schult/midi_concertina/README.md

# MIDI Anglo Concertina

This is a 30-button Anglo Concertina MIDI controller. Click the image below to
watch a short demo:

Demo (https://www.youtube.com/watch?v=fJiAhQMkQ5o)

[Build Instructions](mechanical/README.md)
