schult/midi_concertina/mechanical/README.md

# MIDI Concertina - Mechanical

## Materials

| Quantity | Part |
| ---: | :--- |
| | [PETG Filament](https://shop.polymaker.com/products/polymaker-petg?variant=45079221108793) |
| | [TPU Filament](https://shop.polymaker.com/products/polyflex-tpu95?variant=39574341681209) |
| 34 | [Heat Set Insert M3 x 5.7](https://cnckitchenus.store/products/heat-set-insert-m3-x-5-7-100-pieces) |
| 3 | [M3 x 6mm Button Head Screw](https://boltdepot.com/Product-Details?product=7218) |
| 10 | [M3 x 10mm Button Head Screw](https://boltdepot.com/Product-Details?product=7220) |
| 1 | [M3 x 16mm Button Head Screw](https://boltdepot.com/Product-Details?product=7222) |
| 4 | [M3 x 20mm Button Head Screw](https://boltdepot.com/Product-Details?product=7223) |
| 12 | [M3 x 40mm Flat Head Screw](https://boltdepot.com/Product-Details?product=18839) |
| 2 | [M3 x 8mm Flat Head Screw](https://boltdepot.com/Product-Details?product=7213) |
| 2 | [#6 Finishing Washer](https://boltdepot.com/Product-Details?product=2937) |
| 3' | [16 Gauge Brass Wire](https://www.acehardware.com/departments/hardware/chain-and-rope/wire/52796) |
| 31 | [55g Keyboard Switch Spring](https://www.amazon.com/DUROCK-Mechanical-Keyboard-Compatible-Switches/dp/B09TD7CF3H) |
| 30 | [3mm x 1mm Neodymium Magnet](https://www.amazon.com/MEALOS-Magnets-3mmx1mm-Miniatures-Storage/dp/B08NZSL2V6) |
| 18" | [12 Gauge Steel Hanging Wire](https://www.lowes.com/pd/RELIABILT-1200-in-Hanger-Wire/1002920292) |
|  12" x 3" | [4 oz Black Leather](https://leatherboxusa.com/products/tuscany-collection-soft-vegetable-tanned-vachetta-leather-3-5-4-0) |
| 1 | [Bivar GLP1-188-F-54 Light Pipe](https://www.digikey.com/en/products/detail/bivar-inc/GLP1-188-F-54/26730936) |
| 4 | [Würth Elektronik 6-Pin WR-WST REDFIT IDC](https://www.digikey.com/en/products/detail/w%C3%BCrth-elektronik/490107670612/7917217) |
| 3' | [6 Conductor Ribbon Cable](https://www.digikey.com/en/products/detail/3m/3365-06-300/2766998) |
| 1" | [2mm ID Silicone Tubing](https://www.dubro.com/products/super-blue-slicone-tubing?variant=39705737920596) |
| 24" x 20" | [Tyvek 1073D](https://www.etsy.com/listing/1759067642/75-grams-025mm-thickness-kraft-paper) |
| 16" x 20" | [2-Ply Museum Board](https://www.dickblick.com/items/rising-museum-board-32-x-40-x-2-ply-natural-sheet/) |
| | [PVA Glue](https://www.dickblick.com/products/gorilla-wood-glue/) |
| | [CA Glue](https://www.dickblick.com/products/gorilla-super-glue/) |
| | [1.5mm Elastic Cord](https://www.beadtin.com/products/black-1-5mm-round-elastic-cord-22m) |
| 1 | Controller PCBA |
| 1 | Left Keyboard PCBA |
| 1 | Right Keyboard PCBA |
| 1 | Bellows Sensor PCBA |

## Tools

This is not an exhaustive list. Basic measuring, marking, and cutting tools are
assumed.

### Required

#### FDM 3D Printer

Any modern printer that can print PETG and TPU with a 0.4mm nozzle and a build
volume of at least 180mm x 180mm x 30mm should be up to the task.

#### Soldering Iron and [M3 Heat Set Installation Tip](https://cnckitchenus.store/collections/installation-tips-and-sets-1)

If you don't already have a soldering iron, CNCKitchen
[sells one in a set](https://cnckitchenus.store/products/soldering-iron-t90b?variant=48105538814052)
with the required installation tip included.

There are less expensive tools/methods for installing heat set inserts, but I
can't vouch for the quality of their results.

### IDC Crimping Tool

I use a [3D printed tool](https://www.printables.com/model/1472991-we-wst-connector-6p-manual-press-tool)
in a bench vise.

### Optional

#### Laser Cutter

A laser cutter does a nice job of cutting out hand straps and bellows cards.
A 10W diode laser with air assist is sufficient. Use it if you have it.

#### [Wire Straightener](https://www.amazon.com/dp/B09C5RWY1S)

This should be able to handle both 12 gauge steel wire and 16 gauge brass wire.

This is faster and easier than straightening wires by hand, and it produces
superior results. That said, it's a specialized tool that's not super cheap, so
it's probably not worth the cost if you're only building one instrument.

## 3D Printing Parts

### Part Index

| Quantity | Part |
| ---: | :--- |
| 1 | ActionBoard\_Left |
| 1 | ActionBoard\_Right |
| 2 | BellowsFrame |
| 31 | ButtonBushing |
| 31 | ButtonCap |
| 1 | ButtonFlange\_Air |
| 30 | ButtonFlange\_Note |
| 1 | ControllerPanel |
| 1 | ControllerPanelButton |
| 1 | ControllerPanelRetainer |
| 1 | Faceplate\_Left |
| 1 | Faceplate\_Right |
| 2 | Handrest |
| 31 | MagnetPost |
| 1 | PcbStandoff1\_Left |
| 1 | PcbStandoff1\_Right |
| 2 | PcbStandoff2 |
| 2 | Trim |
| 1 | ValveBlock\_Left |
| 1 | ValveBlock\_Right |

### Parameters

Many key dimensions are stored in spreadsheets in Parameters.FCStd to be
referenced by the other FreeCAD files. A few of these may need to be adjusted to
accomodate your 3d printing setup:

- `CommonParams.clearance_tight` sets the clearance between press-fit 3d-printed
  parts. Test with ControllerPanel and ControllerPanelRetainer, since these
  are smaller parts.
- `HardwareParams.m3_insert_hole_diameter` and
  `HardwareParams.m3_insert_horizontal_hole_diameter` adjust the hole sizes
  for the threaded inserts.
- `ButtonParams.wire_press_fit_diameter` sets the inner diameter for button
  wires to press-fit into. Wires should punch through these layers without
  excessive effort and remain firmly in place once fully seated.
- `ButtonParams.wire_clearance_diameter` sets the size of the ActionBoard holes
  that the wires pass through. These should be as closely fitted as possible
  while still allowing the wires to slide freely.
- `ButtonParams.magnet_diameter` should be adjusted so that the magnets are easy
  to insert into MagnetPost mid-print but don't jump out as the nozzle passes
  over them.
- TODO: Handrest buckle prong hole diameter?
- TODO: Button jig cutter allowance?
- TODO: ControllerPanel light pipe press-fit

When changing these or other spreadsheet values, it is recommended to open
Parameters.FSCStd first, then open all other FreeCAD files, edit the parameters,
and finally recompute the Body in each file before saving it. This ensures that
all dependent parts are correctly updated.

### STL Export

Run `freecadcmd export_all.py` in this directory. The generated STL files will
be placed in the `exports` subdirectory.

### Slicer Settings

#### Base

- PETG
- 0.4 mm nozzle
- 0.2 mm layer height
- 15% Gyroid infill
- 2 wall loops

#### Deviations

The cable guide should be printed with TPU. I also recommend setting the top and
bottom surface patterns to "Concentric".

Bellows gaskets and button flanges should be printed with TPU.

Button caps should be printed with the smallest layer height possible. 0.08 mm
is good. This helps to reduce noise when pressing buttons and produces a
smoother top. It is recommended to use an outer brim when printing this part.

The magnet posts require a pause mid-print in order to insert the magnets.  They
should also be printed with the same layer height as the button caps to ensure
the wire press-fits the same way in both parts.

Handrests have a curved top that benefits from a reduced layer height of 0.12 mm
or less.

Faceplates and the controller panel should be printed with "Only one wall on
first layer" enabled.

I prefer the way the controller panel button looks with the top surface pattern
set to "Concentric".

Parts that incorporate threaded inserts should use 4 wall loops:

- ActionBoard\_Left
- ActionBoard\_Right
- BellowsFrame
- ControllerPanel
- Handrest
- PcbStandoff2
- ValveBlock\_Left
- ValveBlock\_Right

## Assembly Instructions

### Heat Set Inserts

Install heat set inserts in all parts that require them.

#### Left Action Board
Install 2 inserts in the left action board.

The holes for the inserts go all the way through, so check that you are
installing them from the side _without_ the spring pockets. While not strictly
necessary, this helps prevent melted plastic from obstructing the threads.

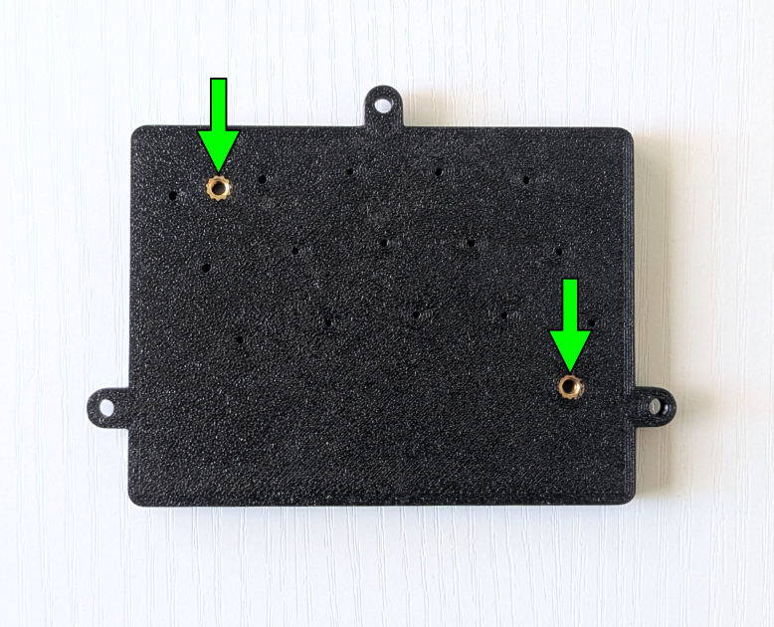
[picture p1: mechanical/docs/images/heat-set-inserts-left-action-board.jpg]
Left Action Board


#### Right Action Board
Install 2 inserts in the right action board.

The holes for the inserts go all the way through, so check that you are
installing them from the side _without_ the spring pockets. While not strictly
necessary, this helps prevent melted plastic from obstructing the threads.

Right Action Board

#### Bellows Frames (2x)
Install 6 inserts in each of the two bellows frames.

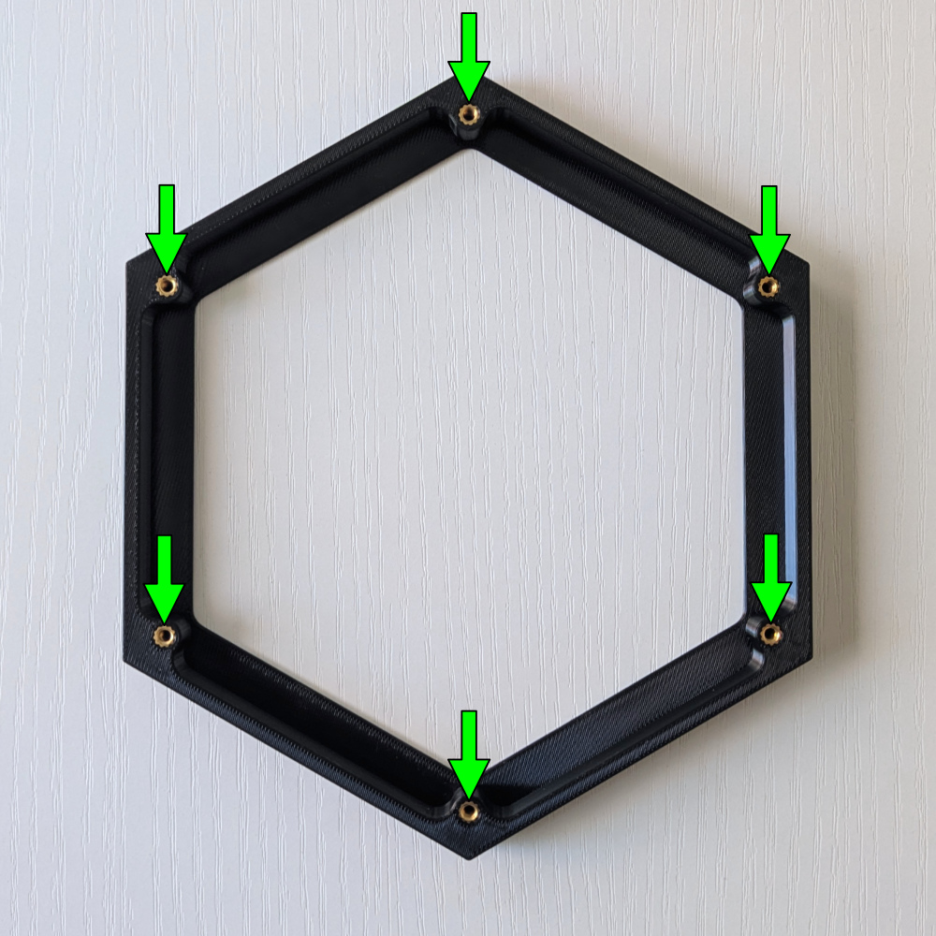
[picture p2: mechanical/docs/images/heat-set-inserts-bellows-frames.jpg]
Bellows Frames


#### Controller Panel
Install 2 inserts in the controller panel.

Controller Panel

#### Handrests (2x)
Install 3 inserts in each of the two handrests.

Handrests

#### PCB Standoffs (2x)
Install 1 insert in each of the two larger PCB standoffs.

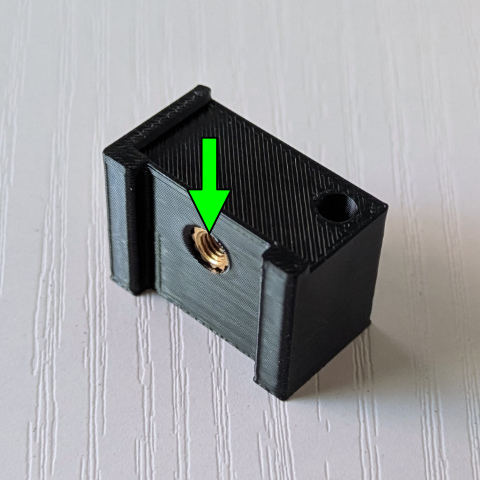
[picture p3: mechanical/docs/images/heat-set-inserts-pcb-standoffs.jpg]
PCB Standoffs


#### Left Valve Block
Install 4 inserts in the left valve block.

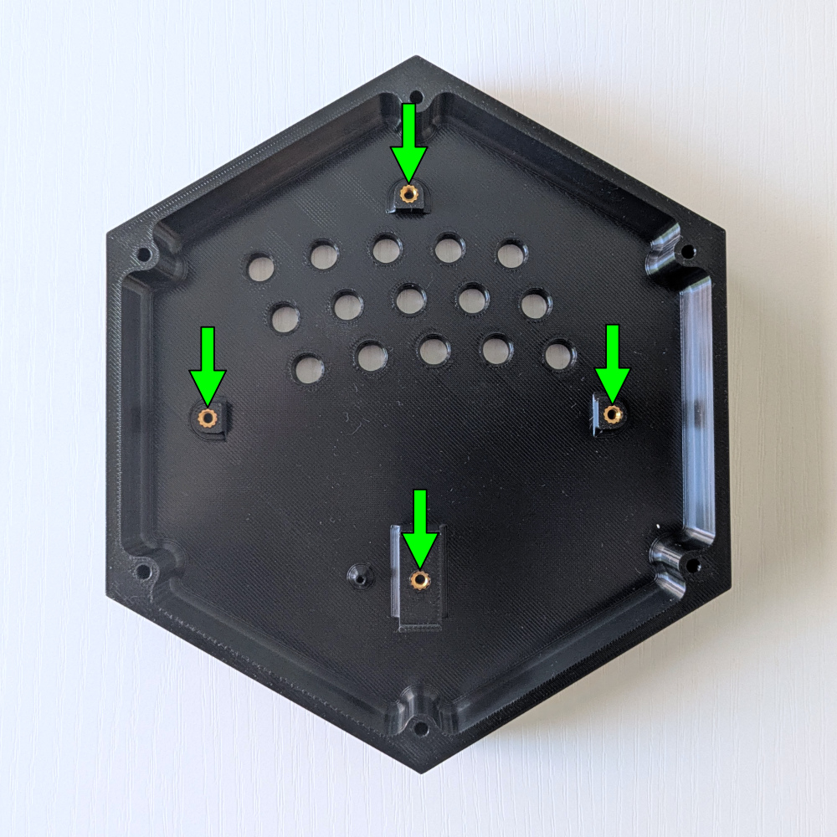
[picture p4: mechanical/docs/images/heat-set-inserts-left-valve-block.jpg]
Left Valve Block


#### Right Valve Block
Install 4 inserts in the right valve block.

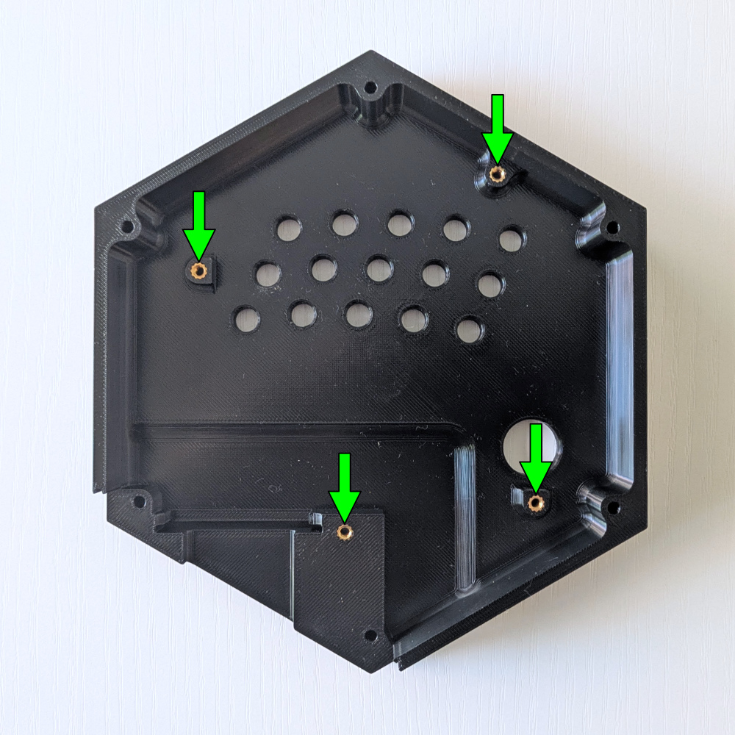
[picture p5: mechanical/docs/images/heat-set-inserts-right-valve-block.jpg]
Right Valve Block


### Handrest Buckles (2x)

Each handrest buckle is constructed from two lengths of straightened 12 gauge
steel hanging wire.

#### Frame

Make marks 12mm, 63mm, 80mm, 121mm, and 136mm from the end of the wire.

Buckle Frame Measurements

At the first mark, hold the wire firmly with pliers on the side closest to the
end, and make a 90-degree bend. Repeat this for each of the following three
marks, making all bends in the same direction.

Buckle Frame Bend 1
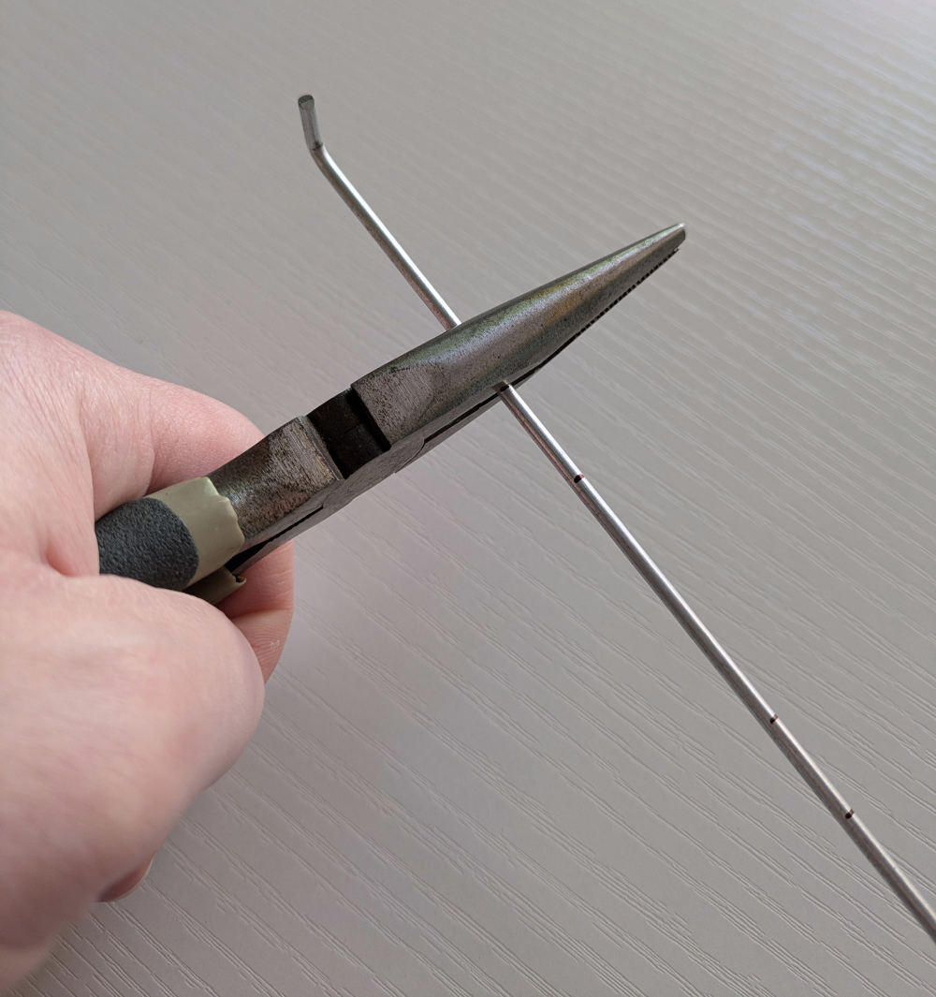
[picture p6: mechanical/docs/images/handrest-buckle-frame-2.jpg]
Buckle Frame Bend 2

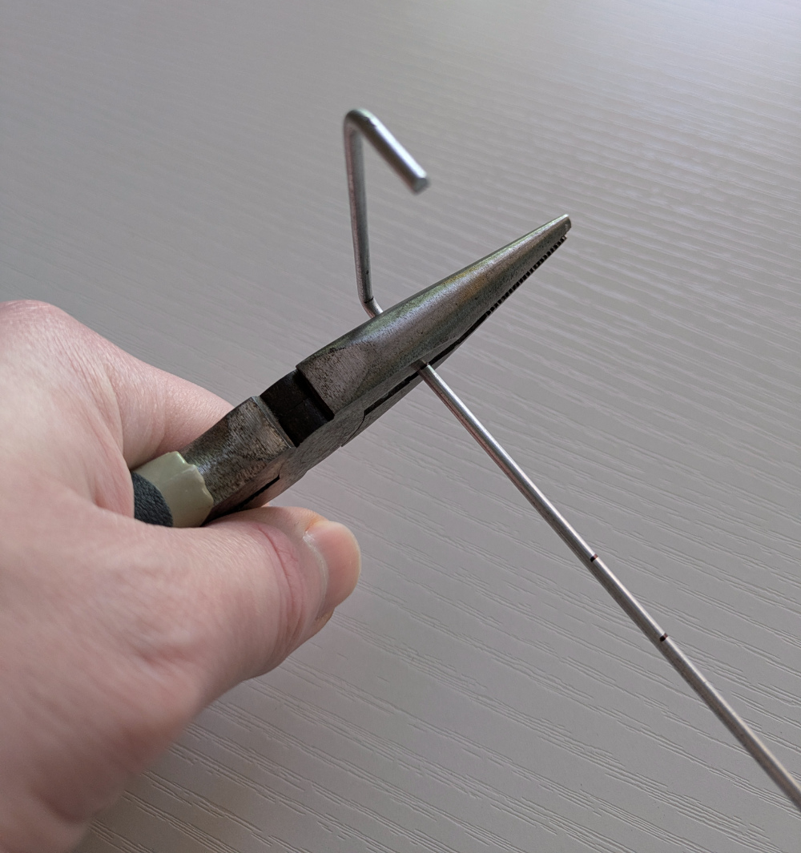
[picture p7: mechanical/docs/images/handrest-buckle-frame-3.jpg]
Buckle Frame Bend 3

Buckle Frame Bend 4

 Cut the wire at the final mark.

Buckle Frame Cut
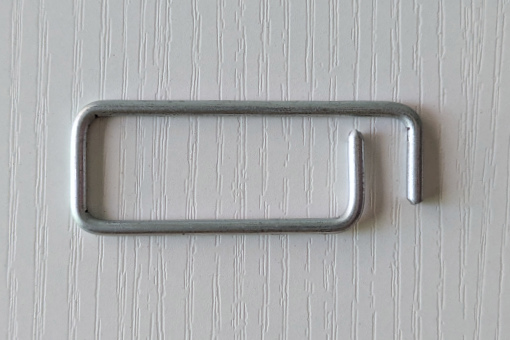
[picture p8: mechanical/docs/images/handrest-buckle-frame-finished.jpg]
Finished Buckle Frame


#### Prong

Round the end of the wire, then cut it to 16 mm long.

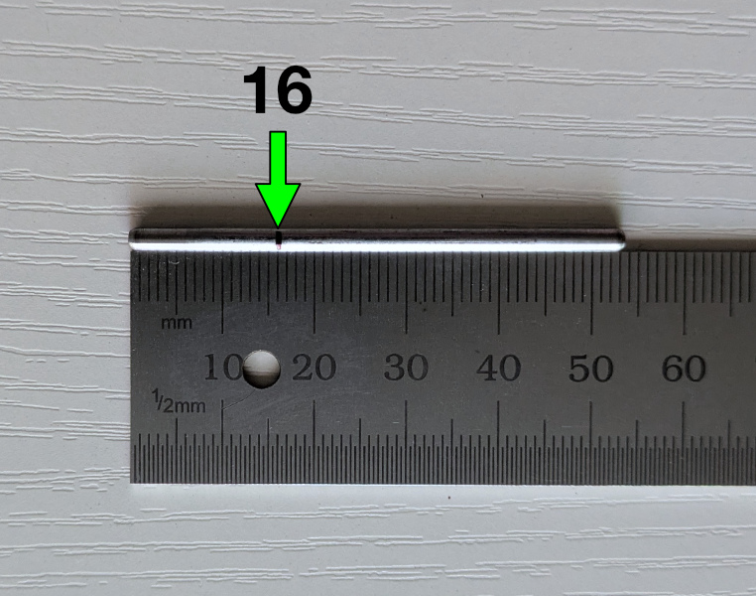
[picture p9: mechanical/docs/images/handrest-buckle-prong-measurements.jpg]
Buckle Prong Measurements

Finished Buckle Prong

#### Installation

With the short leg of the frame below the handrest, fit the longer leg of the
frame into the hole in the middle of the handrest. Pay attention to which side
of the handrest the leg is on (you want the right and left hands to match).

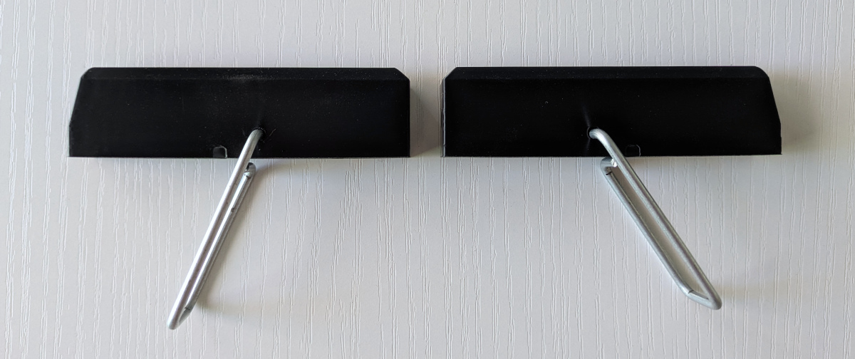
[picture p10: mechanical/docs/images/handrest-buckle-install-1.jpg]
Buckle Installation Step 1


Rotate the frame until the short leg snaps into the notch in the bottom of the
handrest.

Buckle Installation Step 2

Hold the frame past the prong hole while pressing the unfinished end of the
prong into the hole.

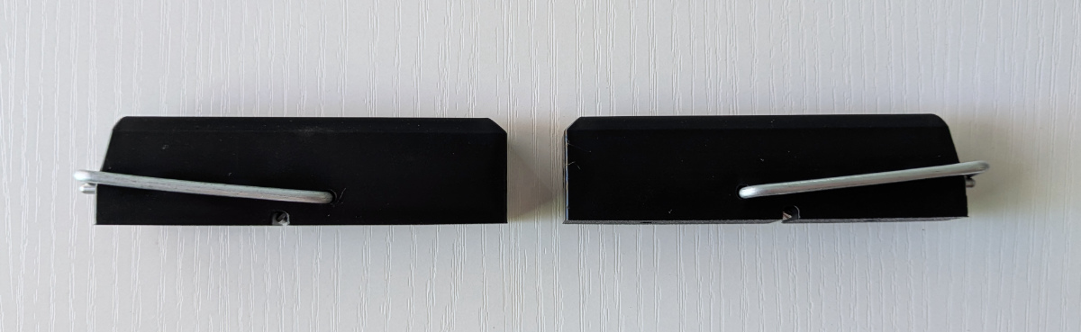
[picture p11: mechanical/docs/images/handrest-buckle-install-3.jpg]
Buckle Installation Step 3


### Faceplates

Press button bushings into all of the faceplate sockets.

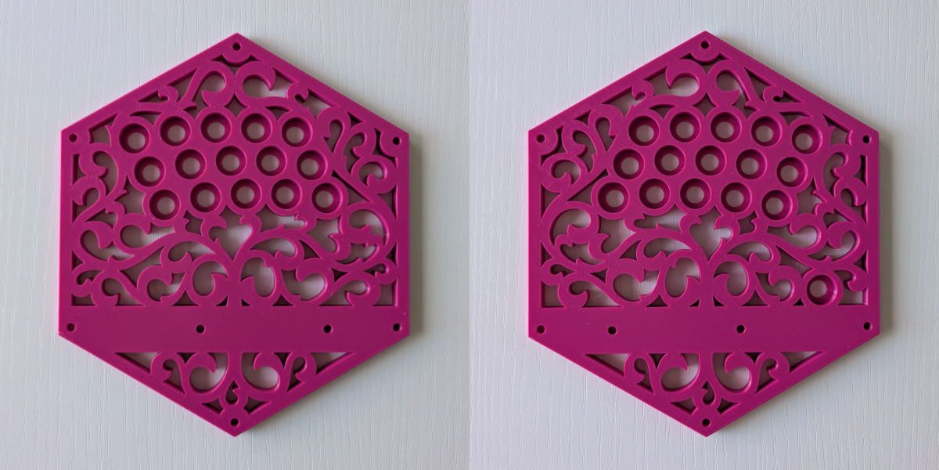
[picture p12: mechanical/docs/images/faceplate-initial.jpg]
Faceplates Without Button Bushings

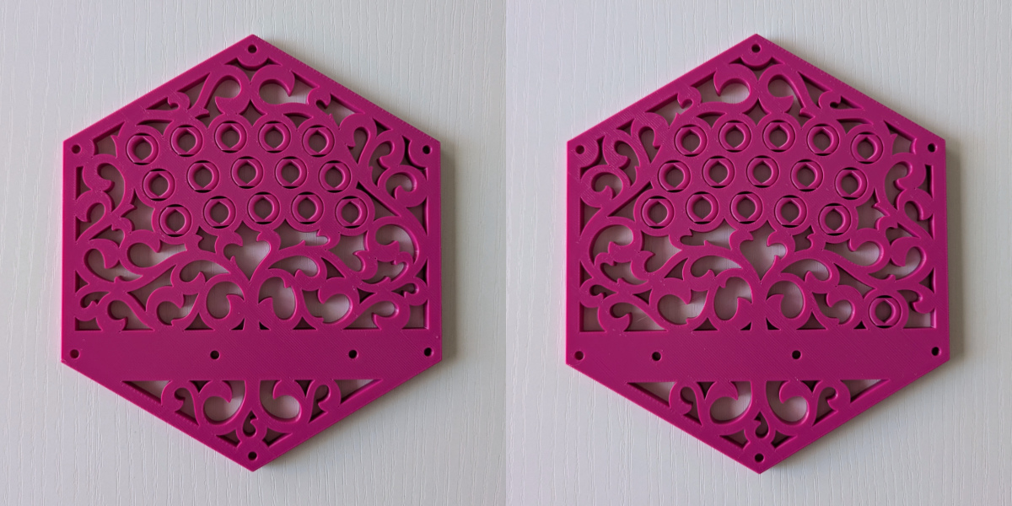
[picture p13: mechanical/docs/images/faceplate-button-bushings.jpg]
Faceplates With Button Bushings


Use two M3 x 10mm screws to bolt a handrest assembly to each faceplate. The
buckle prong should face the closer edge of the faceplate.

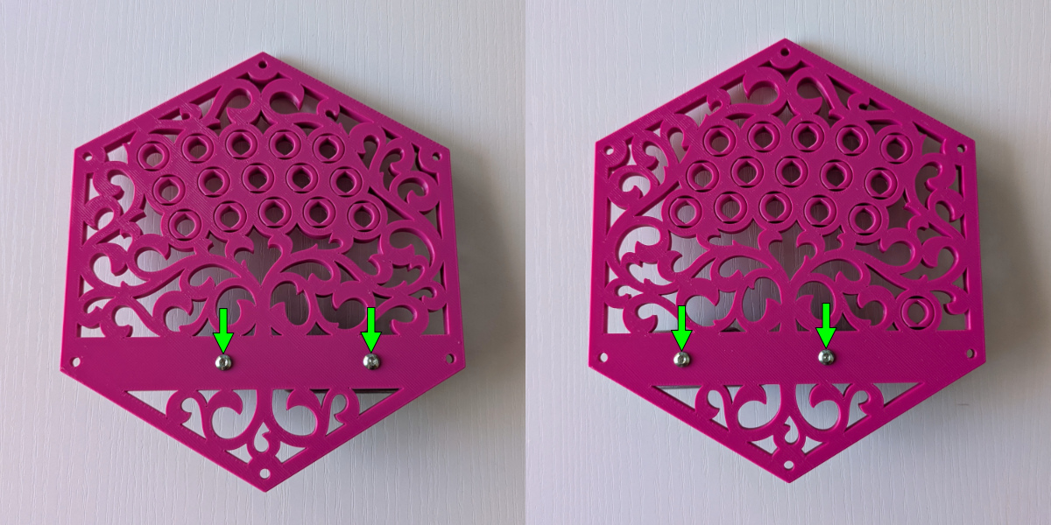
[picture p14: mechanical/docs/images/faceplate-handrest-screws.jpg]
Faceplate Handrest Screws

Faceplate Handrest Orientation

### Buttons

[tools/ButtonWireJig.FCStd](tools/ButtonWireJig.FCStd) is a tool to help with
measuring the button wires and seating them in button caps.

Insert 16 gauge brass wire in the hole in the short edge of the jig until it
stops. Place side cutters flush with the face of the jig and cut the wire. This
should produce a ??mm (TODO) long section of wire. Repeat this for each button.

For each button, insert a wire section in the hole in the long side of the jig.
Press a button cap onto the exposed end of the wire until it is fully seated. To
check that the wire is fully seated, place the wire in the exposed slot in the
jig, with the button cap flush against the side of the jig. The end of the wire
should come to the edge of the jig.

Push a button flange onto each of the wires, with the concave side facing
the button cap. Press it flush with the button cap.

### Action Boards

For each button, place a spring on its wire. Insert the wire through the
counterbored side of one of the holes in the action board. Press a magnet post
onto the end of the wire protruding from the opposite side of the action board.

Attach the action boards to their matching valve blocks with three M3 x ??mm
(TODO) screws each.

### Controller Panel

TODO

### Bellows

Cut a 516mm x 488mm piece of Tyvek. Also cut 42 25mm Tyvek squares.

Mark the card locations on the back side of the Tyvek. Cards should be on a 84mm
x 32mm grid. The first set of cards should hang about halfway off the edge of
the Tyvek, so that when the Tyvek is glued into a tube, the seam falls in the
middle of the cards instead of on the corners. A template to help quickly mark
card locations is included as a layer in [BellowsCards.dxf](BellowsCards.dxf).

Cut 84 cards in the shape found in layer `0` of
[BellowsCards.dxf](BellowsCards.dxf).

Glue the cards down to the Tyvek using PVA glue. Use enough glue that you see a
little squeeze-out when you press each card down. Allow the glue to dry before
continuing.

Fold the Tyvek along the bellows peaks and valleys. Glue 25mm Tyvek squares
across the cards that meet at the bellows valleys to act as a hinge. Allow the
glue to dry before continuing.

Flatten the Tyvek back out, then fold along two sets of corners so that the seam
lines up. Check that the card corners line up. Place a piece of waxed paper
inside the bellows under the seam to prevent gluing it to the opposite side.
Apply glue to the exposed cards and glue the entire seam closed. Allow the glue
to dry before continuing.

Open the bellows into a hexagonal tube, but do not fold the peaks and valleys
yet. Press the bellows frames into each end, pushing them past their final
position. Apply CA glue to the Tyvek where the frames will go. Pull the frames
out to their final position, and fold the Tyvek around them, being careful not
to block or clog the screw inserts. Allow the glue to dry before continuing.

Fold the valleys in and the peaks out. Adjust the gussets so they fold
symmetrically.

Tie seven loops of elastic cord about 270mm in circumference, and place one
around each bellows valley. Align the knots with the seam in the Tyvek.

### Electronics

TODO: Move these paragraphs to other sections?

For all PCBAs, the side with components is the front, and the opposite side is
the back. When viewing the back of a PCBA, its top and bottom edge can be found
by orienting it so that its name and revision are right-side up.

For each keyboard PCBA, insert two M3 x ??mm (TODO) screw through the holes in
its back. Place the PCB standoffs on the screws. Standoff 1 is for the top
corner and standoff 2 is for the bottom corner. Screw the PCBA to its matching
action board, making sure the standoffs are oriented correctly.

Cut a ??mm (TODO) length of 2mm ID silicone tubing
TODO: Bellows sensor

TODO: Flash controller
TODO: Install Controller
TODO: Connect cable (through bellows!)
TODO: Flash keyboards

### Close the Box

TODO

### Hand Straps

Match the hand straps to the correct ends of the instrument (they should curve
toward the player once installed). Use an M3 x 8mm screw with a #6 finishing
washer to attach the short end of the strap to the handrest. Insert the long end
of the strap into the buckle.

## License

[CERN Open Hardware Licence Version 2 - Strongly Reciprocal](LICENSE.txt)
