schult/midi_concertina/electrical/README.md

# MIDI Concertina - Electrical

These boards are designed to be produced using [JLCPCB](jlcpcb.com)'s Economic
PCBA service. I recommend exporting them with
[Fabrication Toolkit](https://github.com/bennymeg/Fabrication-Toolkit).

## License

[CERN Open Hardware Licence Version 2 - Strongly Reciprocal](LICENSE.txt)
