schult/midi_concertina/mechanical/docs/images/button-wire-press-2.jpg

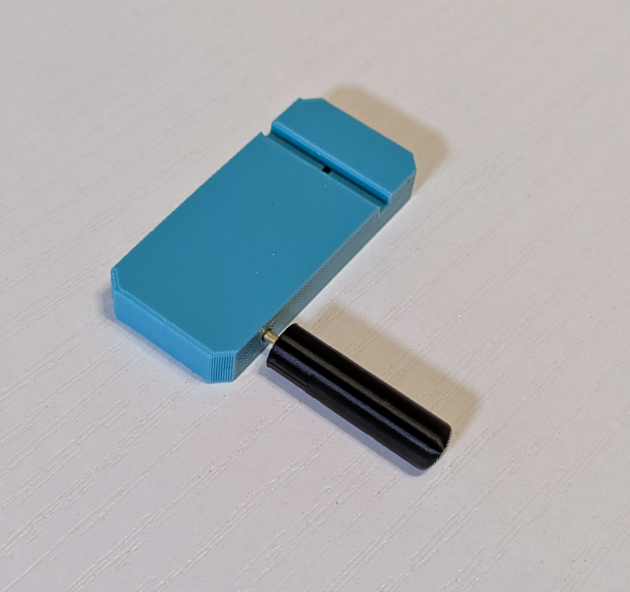
mechanical/docs/images/button-wire-press-2.jpg
