schult/midi_concertina/mechanical/docs/images/button-wire-protrusion-check.jpg

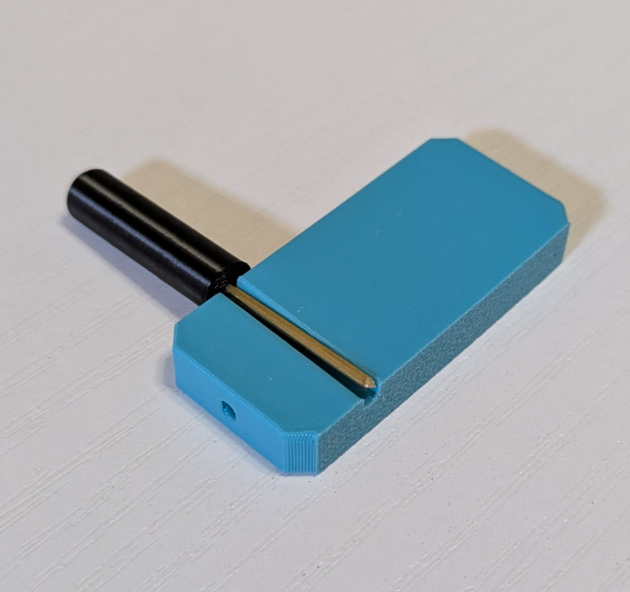
mechanical/docs/images/button-wire-protrusion-check.jpg
