schult/midi_concertina/mechanical/CableGuide.FCStd

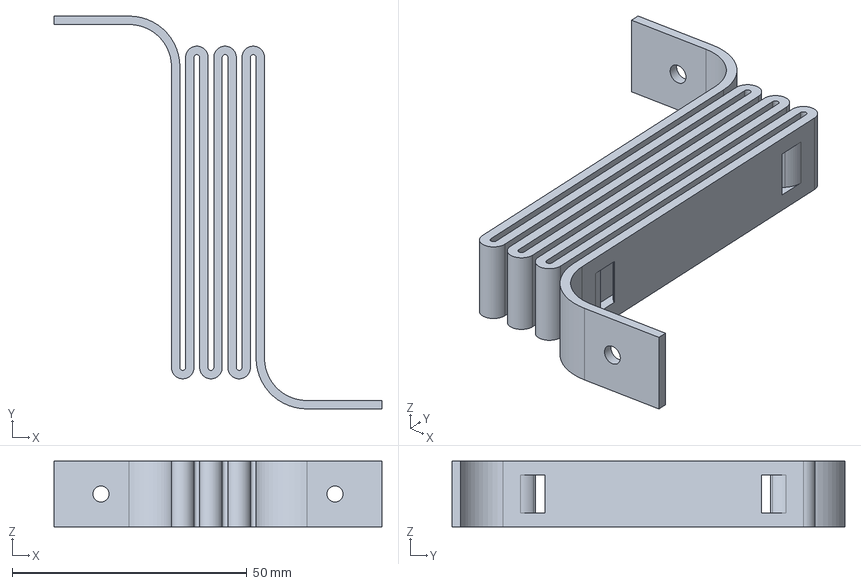
[picture p17: CAD file, 2026-07-04]
mechanical/CableGuide.FCStd
69.8 x 83.6 x 14.0 mm
