schult/midi_concertina/mechanical/tools/ButtonWireJig.FCStd

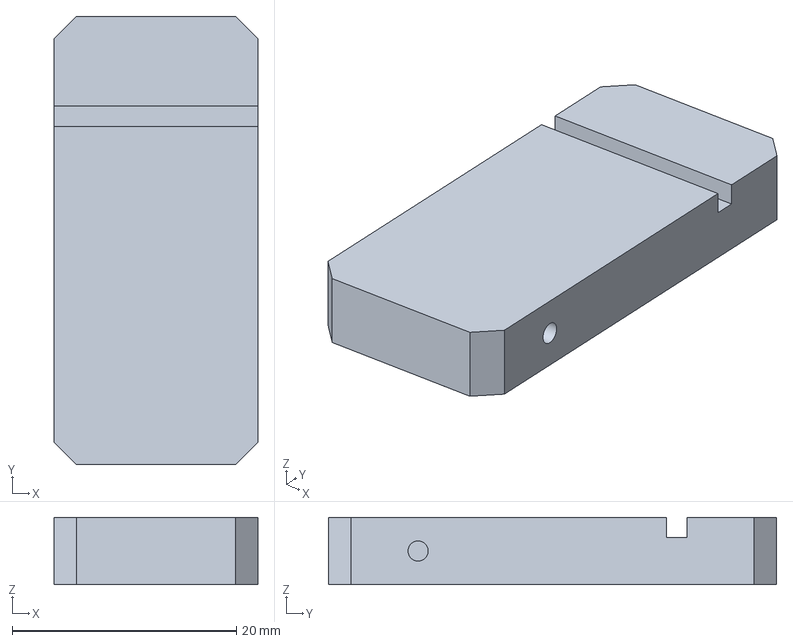
[picture p18: CAD file, 2026-04-11]
mechanical/tools/ButtonWireJig.FCStd
18.2 x 40.0 x 6.00 mm
