schult/midi_concertina/mechanical/PcbStandoff2.FCStd

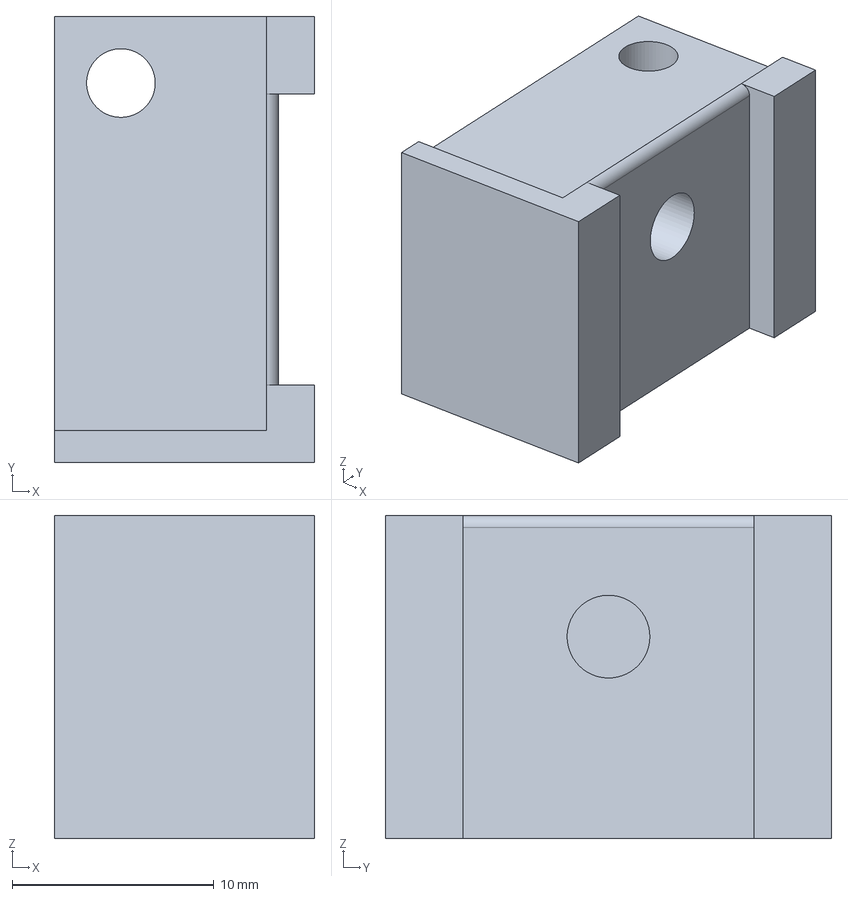
[picture p19: CAD file, 2026-07-04]
mechanical/PcbStandoff2.FCStd
12.9 x 22.1 x 16.0 mm
