schult/midi_concertina/mechanical/BellowsGasket.FCStd

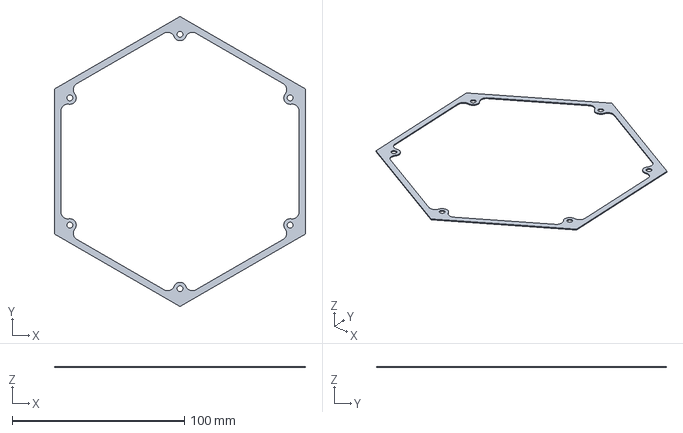
[picture p20: CAD file, 2026-06-06]
mechanical/BellowsGasket.FCStd
145.6 x 168.1 x 0.6 mm
