schult/midi_concertina/mechanical/ValveBlock_Left.FCStd

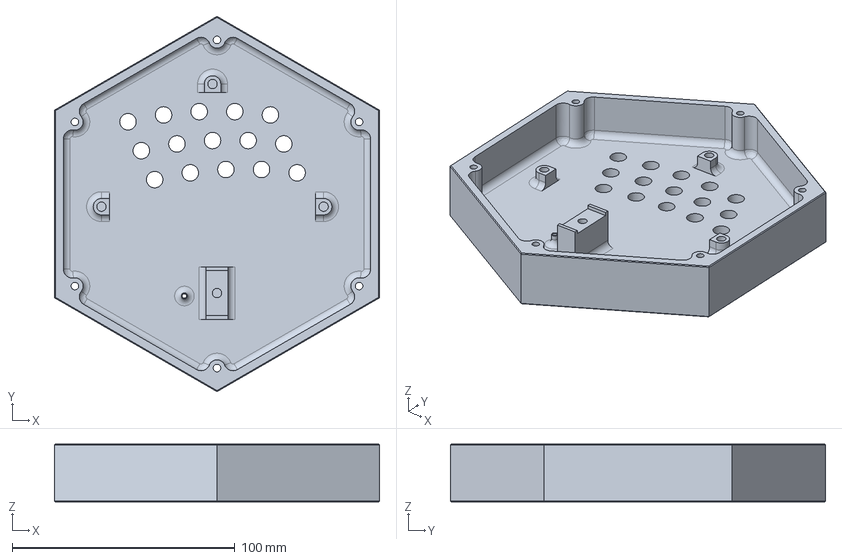
[picture p21: CAD file, 2026-04-22]
mechanical/ValveBlock_Left.FCStd
146.0 x 168.6 x 26.0 mm
