schult/midi_concertina/mechanical/ValveBlock_Right.FCStd

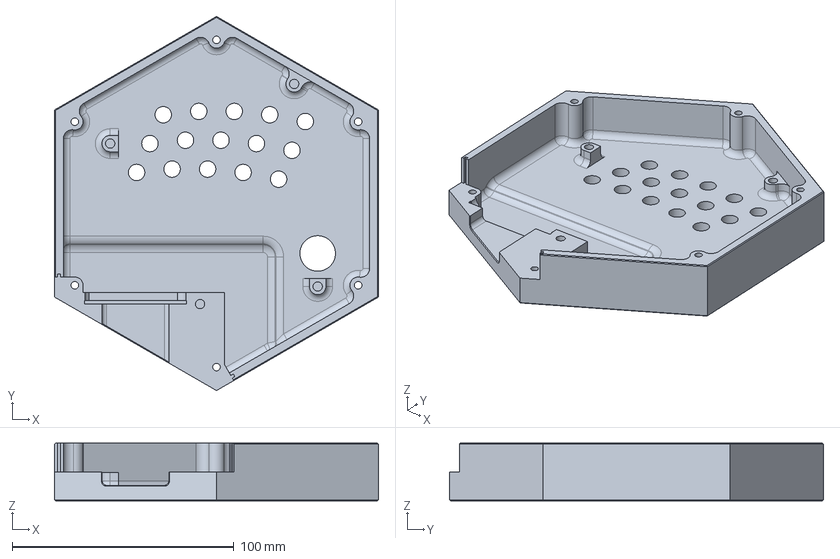
[picture p22: CAD file, 2026-04-22]
mechanical/ValveBlock_Right.FCStd
146.0 x 168.6 x 26.0 mm
