schult/midi_concertina/mechanical/ActionBoard_Left.FCStd

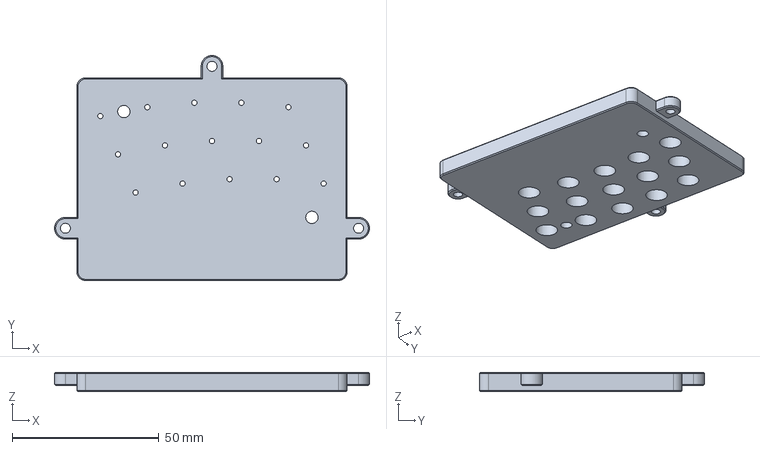
[picture p23: CAD file, 2026-04-18]
mechanical/ActionBoard_Left.FCStd
107.2 x 76.6 x 6.60 mm
