schult/midi_concertina/mechanical/BellowsCards.dxf

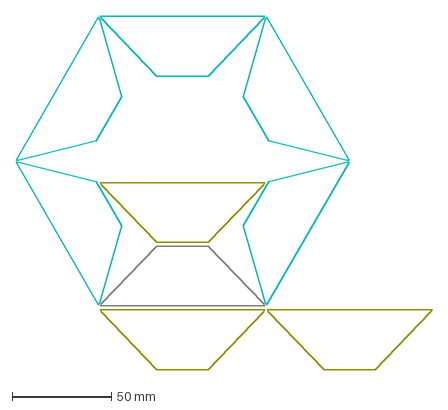
[picture p24: CAD file, 2026-04-11]
mechanical/BellowsCards.dxf
209.1 x 177.5 mm
