schult/midi_concertina/mechanical/ControllerPanelButton.FCStd

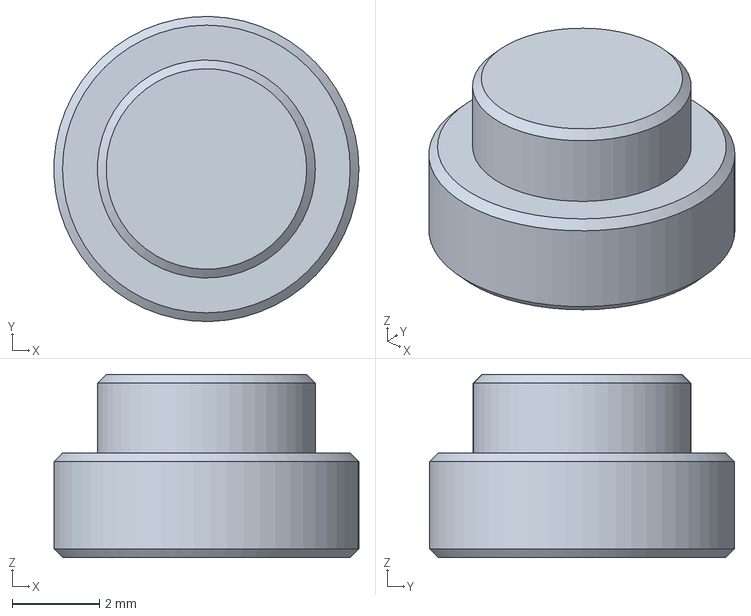
[picture p25: CAD file, 2026-04-11]
mechanical/ControllerPanelButton.FCStd
6.99 x 7.00 x 4.20 mm
