schult/midi_concertina/mechanical/PcbStandoff1_Left.FCStd

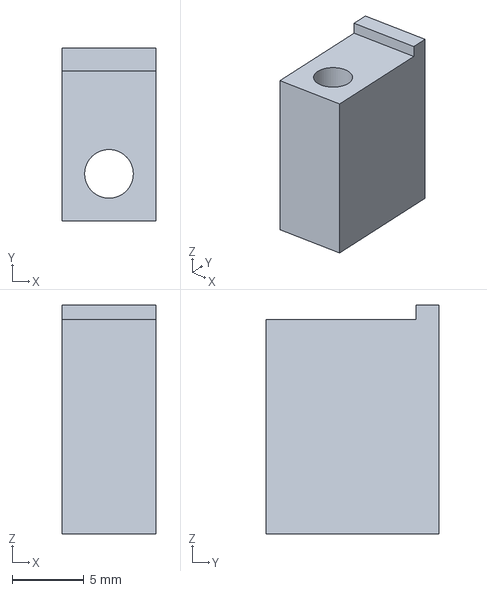
[picture p26: CAD file, 2026-04-09]
mechanical/PcbStandoff1_Left.FCStd
6.60 x 12.1 x 16.0 mm
