schult/midi_concertina/mechanical/PcbStandoff1_Right.FCStd

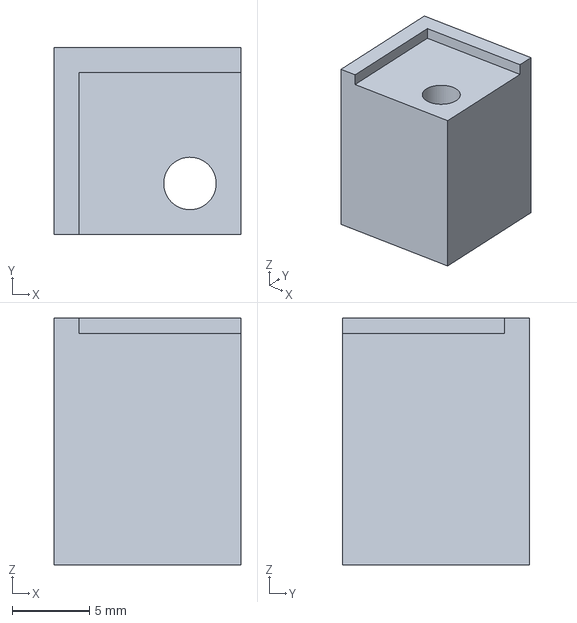
[picture p27: CAD file, 2026-04-09]
mechanical/PcbStandoff1_Right.FCStd
12.1 x 12.1 x 16.0 mm
