schult/midi_concertina/mechanical/ControllerPanelRetainer.FCStd

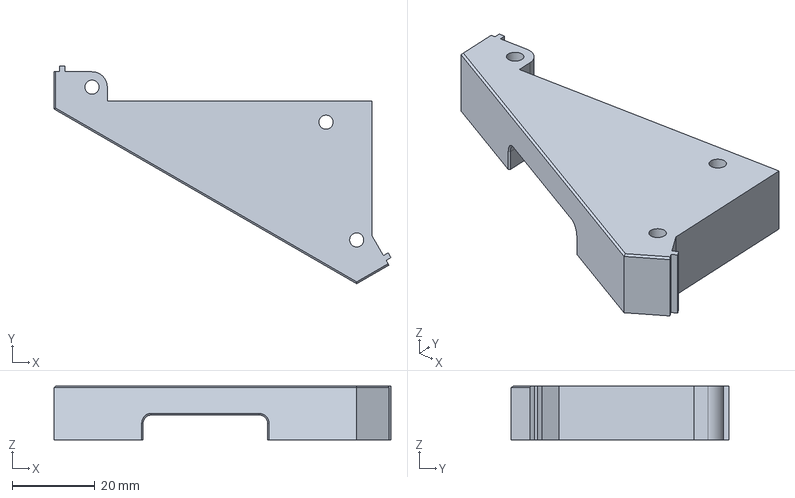
[picture p28: CAD file, 2026-04-05]
mechanical/ControllerPanelRetainer.FCStd
81.3 x 52.5 x 13.0 mm
