schult/midi_concertina/mechanical/ActionBoard_Right.FCStd

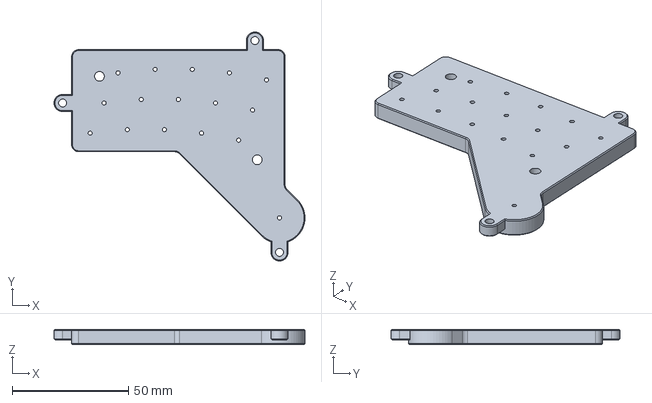
[picture p29: CAD file, 2026-04-05]
mechanical/ActionBoard_Right.FCStd
108.2 x 98.7 x 6.60 mm
