schult/midi_concertina/mechanical/Trim.FCStd

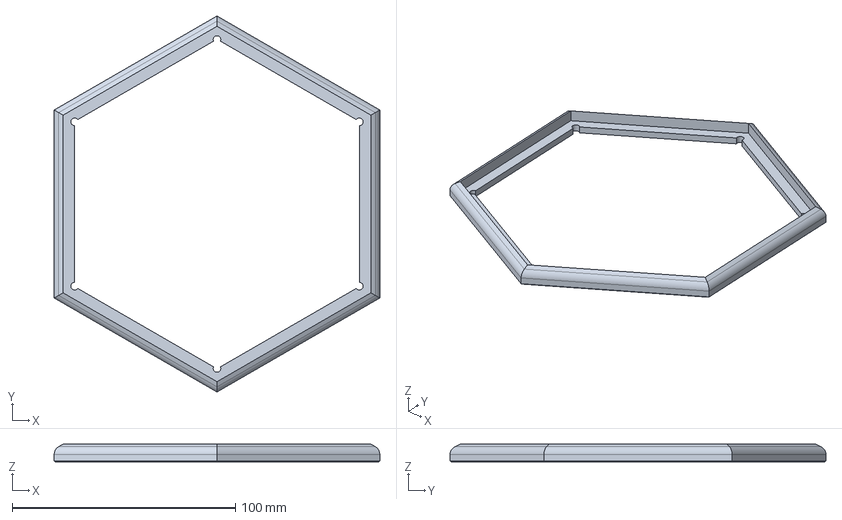
[picture p30: CAD file, 2026-04-05]
mechanical/Trim.FCStd
146.0 x 168.6 x 8.00 mm
