schult/midi_concertina/mechanical/ButtonFlange_Note.FCStd

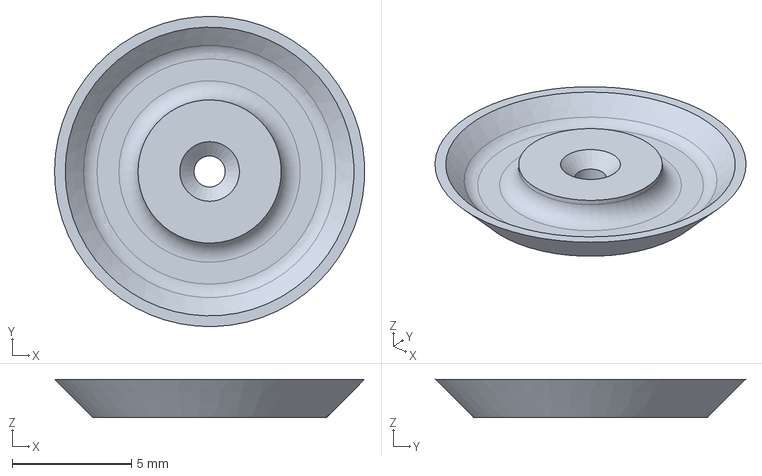
[picture p31: CAD file, 2026-04-05]
mechanical/ButtonFlange_Note.FCStd
13.0 x 13.0 x 1.60 mm
