schult/midi_concertina/mechanical/ButtonBushing.FCStd

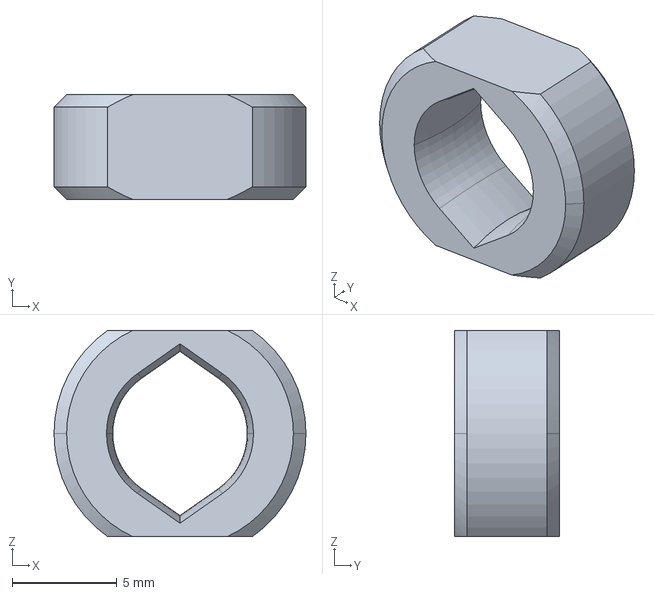
[picture p32: CAD file, 2026-04-05]
mechanical/ButtonBushing.FCStd
12.0 x 5.00 x 9.83 mm
