schult/midi_concertina/mechanical/Handrest.FCStd

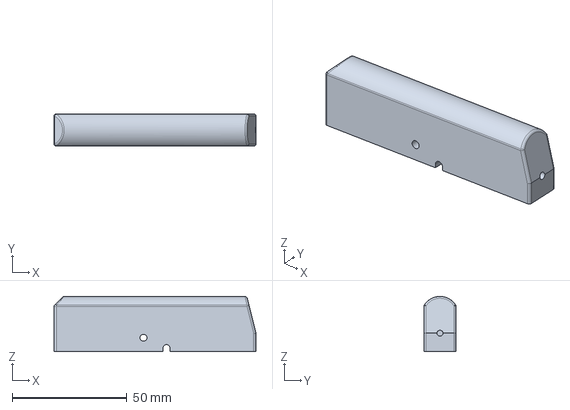
[picture p33: CAD file, 2026-04-05]
mechanical/Handrest.FCStd
88.0 x 14.0 x 24.0 mm
