schult/midi_concertina/mechanical/Faceplate_Left.FCStd

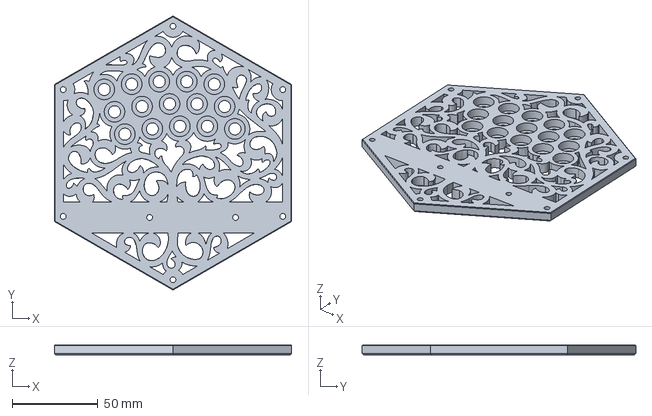
[picture p34: CAD file, 2026-04-05]
mechanical/Faceplate_Left.FCStd
138.0 x 159.3 x 6.00 mm
