schult/midi_concertina/mechanical/ButtonCap.FCStd

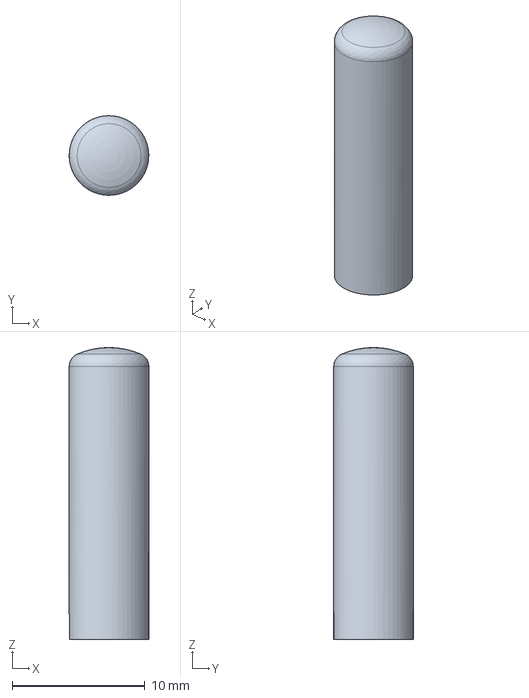
[picture p35: CAD file, 2026-04-05]
mechanical/ButtonCap.FCStd
6.00 x 6.00 x 22.0 mm
