schult/midi_concertina/mechanical/BellowsFrame.FCStd

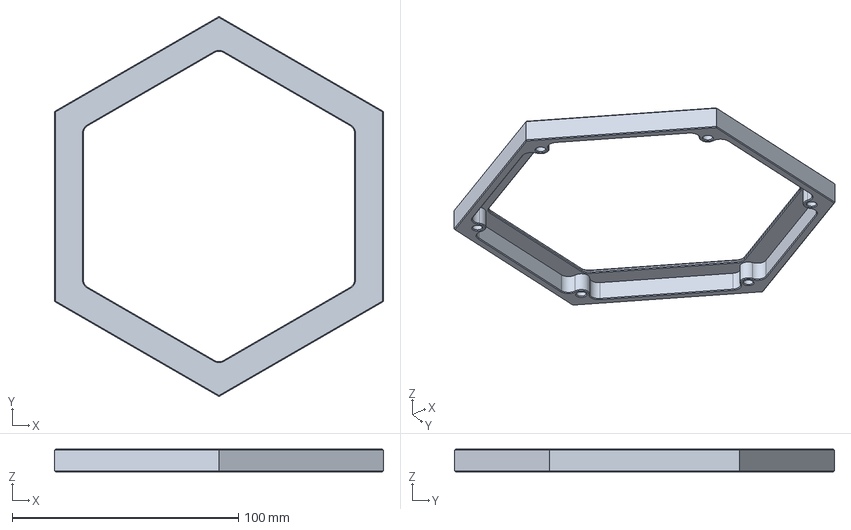
[picture p36: CAD file, 2026-04-05]
mechanical/BellowsFrame.FCStd
145.6 x 168.1 x 10.0 mm
