schult/midi_concertina/mechanical/ControllerPanel.FCStd

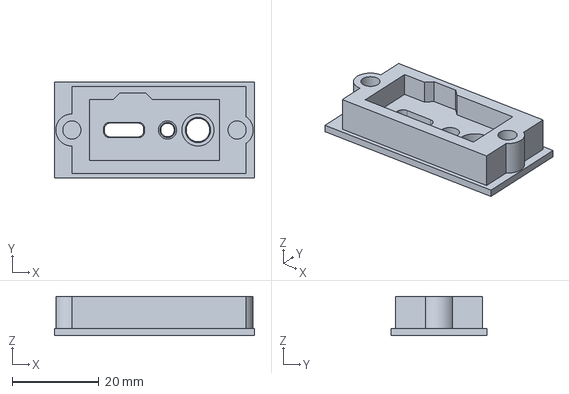
[picture p37: CAD file, 2026-04-05]
mechanical/ControllerPanel.FCStd
46.0 x 22.0 x 9.06 mm
