schult/midi_concertina/mechanical/MagnetPost.FCStd

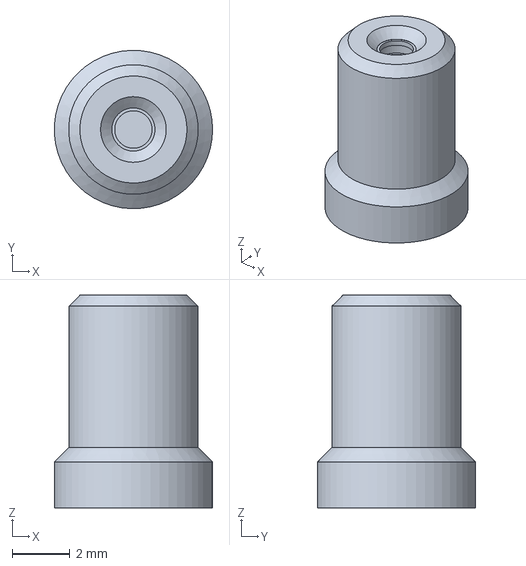
[picture p38: CAD file, 2026-04-05]
mechanical/MagnetPost.FCStd
5.49 x 5.50 x 7.40 mm
