schult/midi_concertina/mechanical/ButtonFlange_Air.FCStd

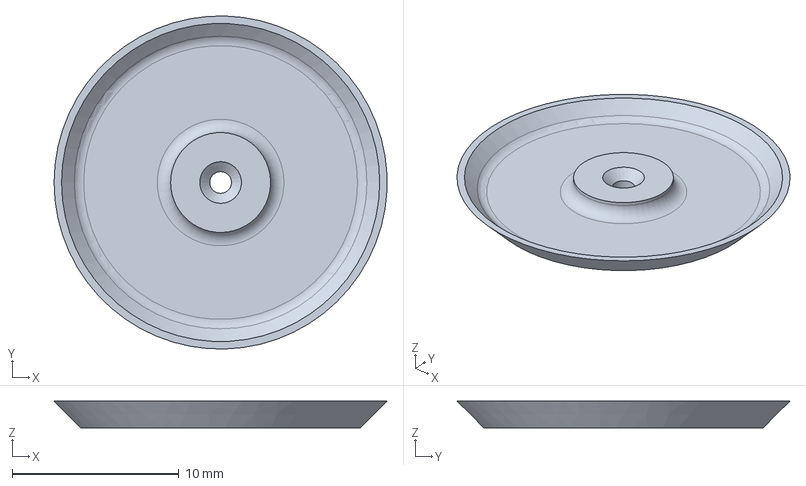
[picture p39: CAD file, 2026-04-05]
mechanical/ButtonFlange_Air.FCStd
20.0 x 20.0 x 1.60 mm
