schult/midi_concertina/mechanical/Straps.dxf

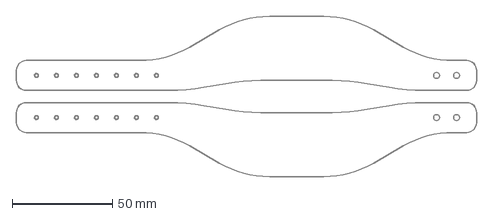
[picture p40: CAD file, 2026-03-12]
mechanical/Straps.dxf
230.0 x 80.0 mm
