schult/midi_concertina/(list of files, cad)

Other CAD files:
mechanical/Parameters.FCStd
mechanical/Faceplate_Right.FCStd
