schult/midi_concertina/mechanical/docs/images/button-jig-print-orientation.jpg

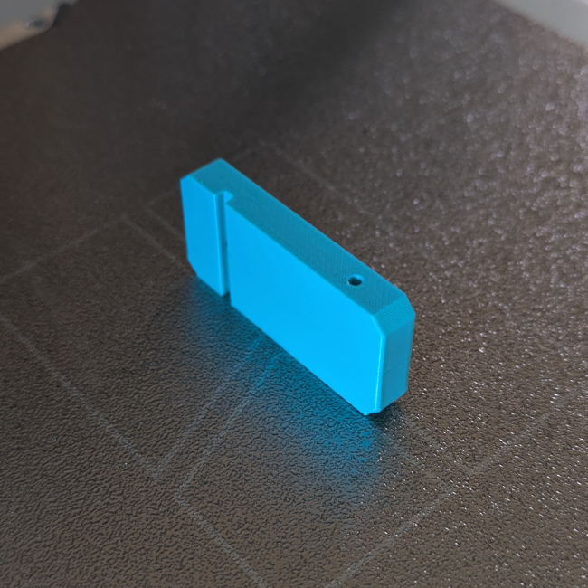
mechanical/docs/images/button-jig-print-orientation.jpg
