schult/midi_concertina/electrical/BellowsSensorA/BellowsSensorA.kicad_pcb

## KiCad design electrical/BellowsSensorA/BellowsSensorA.kicad_pcb (2026-03-29)

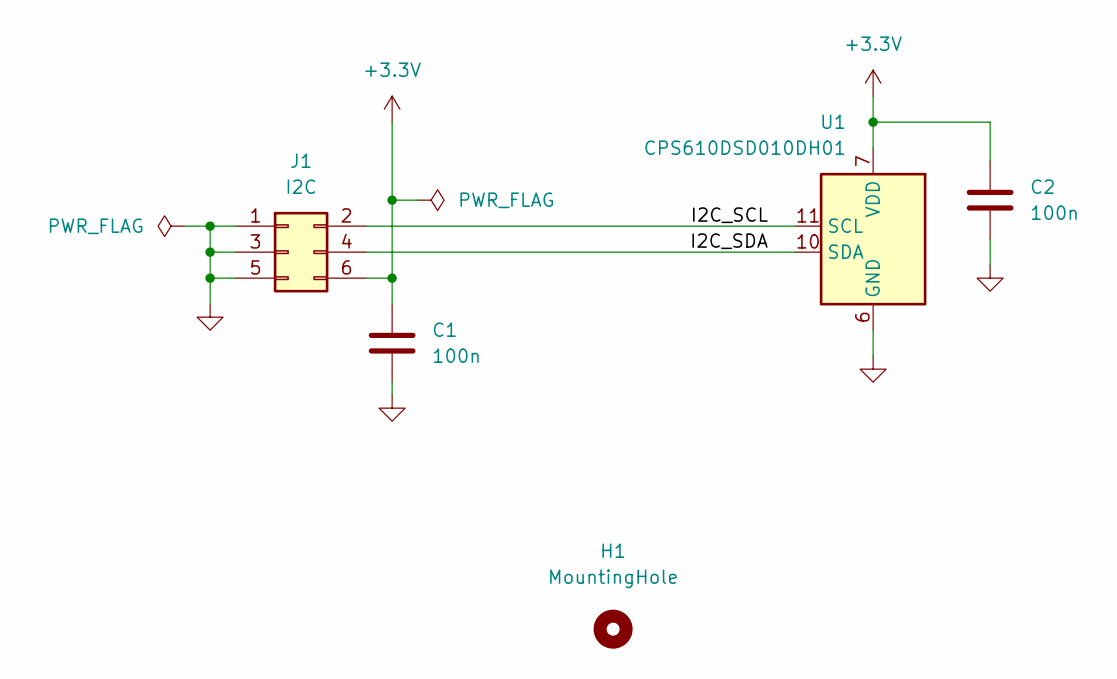
[picture p42: schematic BellowsSensorA.kicad_sch, MIDI Bellows Sensor A]

Parts:
C1, C2: 100n; C_0402_1005Metric; Part Samsung CL05B104KO5NNNC; LCSC C1525
H1: MountingHole; MountingHole_3.2mm_M3
J1: I2C; Wuerth_WR-WST_490107670612_2x03_P2.54mm_SKEDD
U1: CPS610DSD010DH01; SOIC-16W_7.5x10.3mm_P1.27mm; Part Consensic CPS610DSD010DH01; LCSC C28646450

Connections:
+3.3V: C1.1, C2.1, J1.6, U1.7 (VDD)
/I2C_SCL: J1.2, U1.11 (SCL)
/I2C_SDA: J1.4, U1.10 (SDA)
GND: C1.2, C2.2, J1.1, J1.3, J1.5, U1.6 (GND)

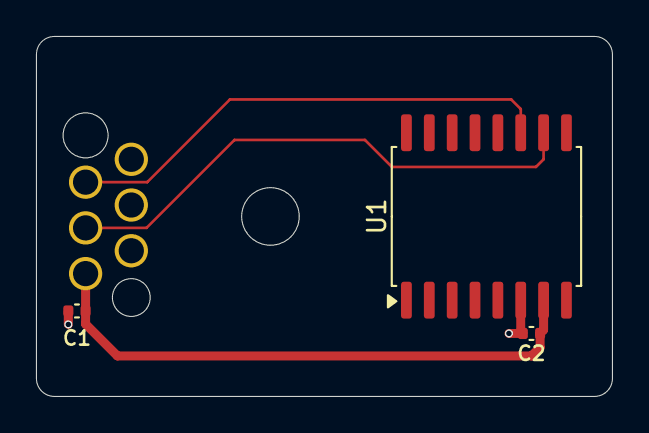
[picture p43: board BellowsSensorA.kicad_pcb from above]

Board: 2 copper layers, 32.0 x 20.0 mm, 5 parts (1 on the bottom side), 4 nets.
