schult/midi_concertina/electrical/Controller/Controller.kicad_pcb

## KiCad design electrical/Controller/Controller.kicad_pcb (2026-01-20)

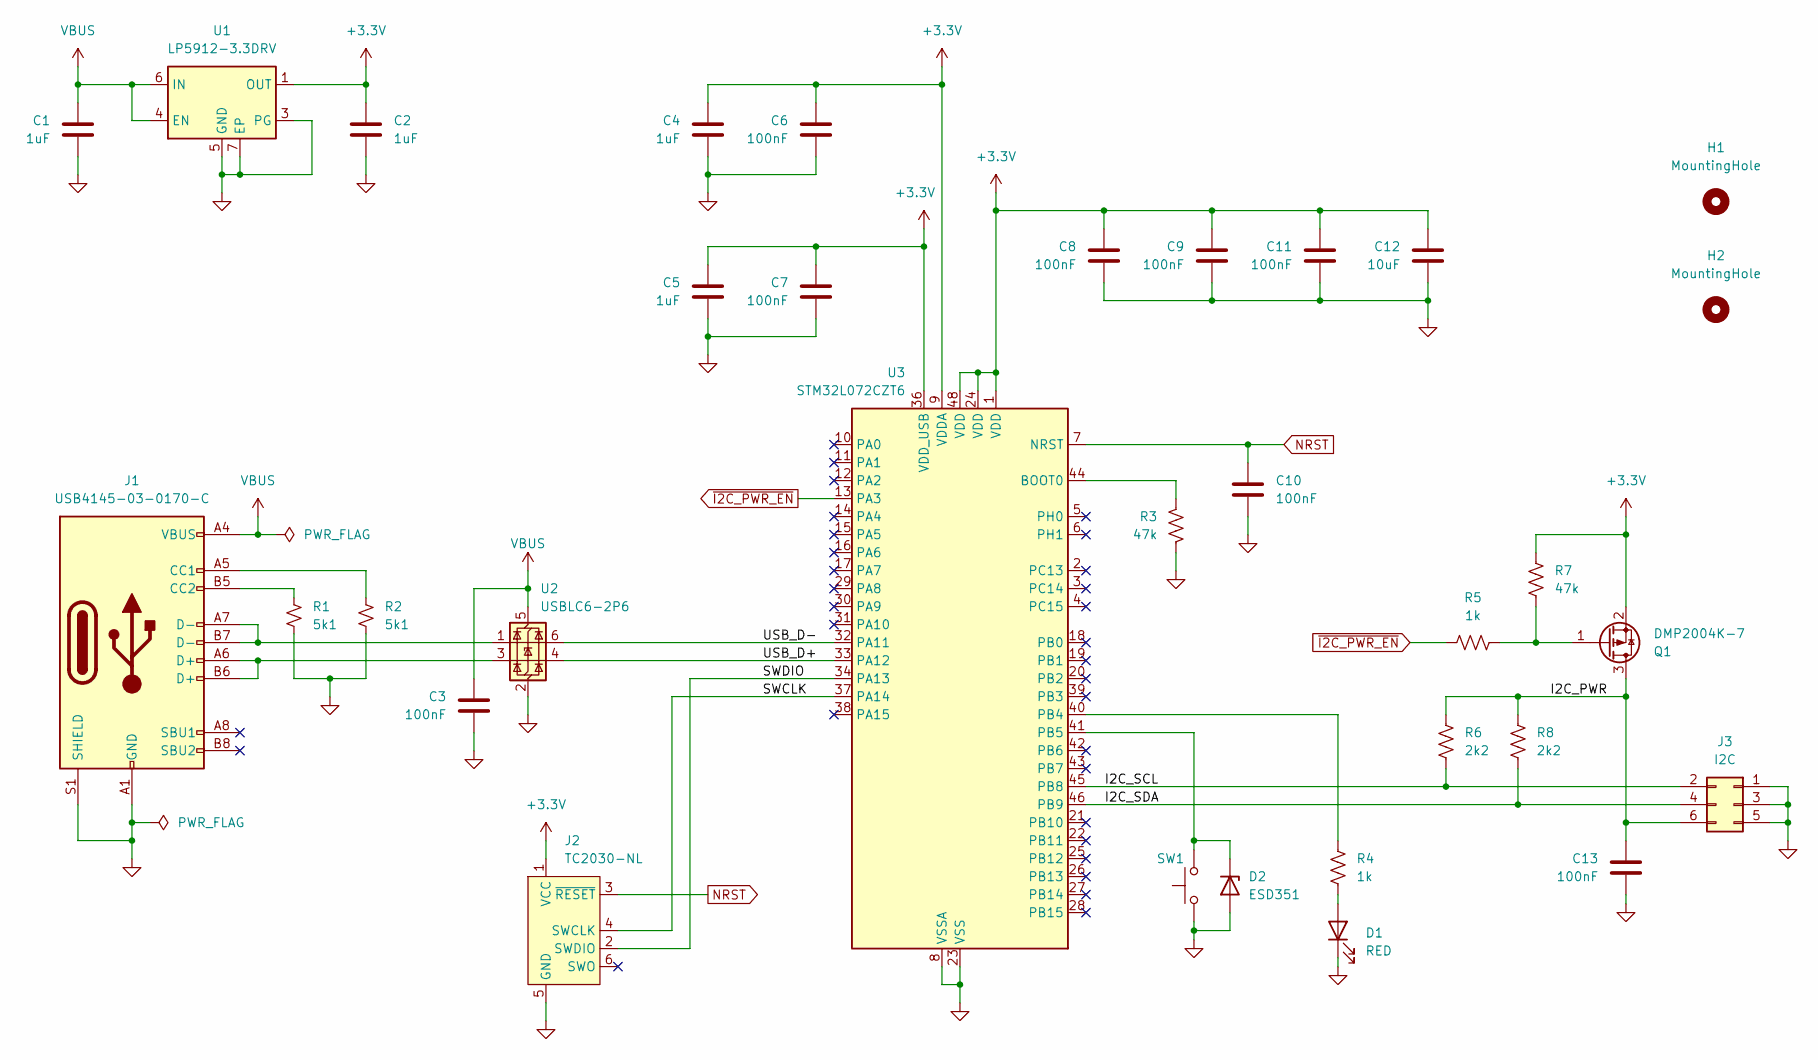
[picture p44: schematic Controller.kicad_sch, MIDI Concertina Controller]

Parts:
C1, C2, C4, C5: 1uF; C_0402_1005Metric; Part Samsung CL05A105KA5NQNC; LCSC C52923
C3, C6, C7, C8, C9, C10, C11, C13: 100nF; C_0402_1005Metric; Part Samsung CL05B104KO5NNNC; LCSC C1525
C12: 10uF; C_0603_1608Metric; Part Samsung CL10A106MA8NRNC; LCSC C96446
D1: RED; LED_0603_1608Metric; Part KENTO KT-0603R; LCSC C2286
D2: ESD351; Texas_DPY0002A_0.6x1mm_P0.65mm; Part TI ESD351DPYR; LCSC C1974929
H1, H2: MountingHole; MountingHole_3.2mm_M3
J1: USB4145-03-0170-C; USB_C_Receptacle_GCT-USB4145; Part GCT USB4145-03-0170-C; LCSC C5181332
J2: TC2030-NL; Tag-Connect_TC2030-IDC-NL_2x03_P1.27mm_Vertical
J3: I2C; Wuerth_WR-WST_490107670612_2x03_P2.54mm_SKEDD
Q1: DMP2004K-7; SOT-23; Part Diodes Incorporated DMP2004K-7; LCSC C332297
R1, R2: 5k1; R_0603_1608Metric; Part UNI-ROYAL 0603WAF5101T5E; LCSC C23186
R3, R7: 47k; R_0402_1005Metric; Part UNI-ROYAL 0402WGF4702TCE; LCSC C25792
R4, R5: 1k; R_0402_1005Metric; Part UNI-ROYAL 0402WGF1001TCE; LCSC C11702
R6, R8: 2k2; R_0603_1608Metric; Part UNI-ROYAL 0603WAF2201T5E; LCSC C4190
SW1: SW_Push_1P1T_NO_E-Switch_TL3301NxxxxxG; Part E-Switch TL3301AF160QG; LCSC C273519
U1: LP5912-3.3DRV; WSON-6-1EP_2x2mm_P0.65mm_EP1x1.6mm_ThermalVias; Part TI LP5912-3.3DRVR; LCSC C524780
U2: USBLC6-2P6; SOT-666; Part ST USBLC6-2P6; LCSC C15999
U3: STM32L072CZT6; LQFP-48_7x7mm_P0.5mm; Part STM32L072CZT6; LCSC C1337587

Connections:
+3.3V: C2.1, C4.1, C5.1, C6.1, C7.1, C8.1, C9.1, C11.1, C12.1, J2.1 (VCC), Q1.2 (S), R7.1, U1.1 (OUT), U3.1 (VDD), U3.9 (VDDA), U3.24 (VDD), U3.36 (VDD_USB), U3.48 (VDD)
/I2C_PWR: C13.1, J3.6, Q1.3 (D), R6.1, R8.1
/I2C_SCL: J3.2, R6.2, U3.45 (PB8)
/I2C_SDA: J3.4, R8.2, U3.46 (PB9)
/SWCLK: J2.4 (SWCLK), U3.37 (PA14)
/SWDIO: J2.2 (SWDIO), U3.34 (PA13)
/USB_D+: U2.4 (I/O2), U3.33 (PA12)
/USB_D-: U2.6 (I/O1), U3.32 (PA11)
GND: C1.2, C2.2, C3.2, C4.2, C5.2, C6.2, C7.2, C8.2, C9.2, C10.2, C11.2, C12.2, C13.2, D1.1 (K), D2.2 (A), J1.A1 (GND), J1.A12 (GND), J1.B1 (GND), J1.B12 (GND), J1.S1 (SHIELD), J2.5 (GND), J3.1, J3.3, J3.5, R1.2, R2.2, R3.2, SW1.2, U1.3 (PG), U1.5 (GND), U1.7 (EP), U2.2 (GND), U3.8 (VSSA), U3.23 (VSS), U3.35 (VSS), U3.47 (VSS)
NRST: C10.1, J2.3 (~RESET), U3.7 (NRST)
unnamed: D1.2 (A), R4.2
unnamed: D2.1 (K), SW1.1, U3.41 (PB5)
unnamed: J1.A5 (CC1), R2.1
unnamed: J1.B5 (CC2), R1.1
unnamed: J1.A6 (D+), J1.B6 (D+), U2.3 (I/O2)
unnamed: J1.A7 (D-), J1.B7 (D-), U2.1 (I/O1)
unnamed: Q1.1 (G), R5.2, R7.2
unnamed: R3.1, U3.44 (BOOT0)
unnamed: R4.1, U3.40 (PB4)
VBUS: C1.1, C3.1, J1.A4 (VBUS), J1.A9 (VBUS), J1.B4 (VBUS), J1.B9 (VBUS), U1.4 (EN), U1.6 (IN), U2.5 (VBUS)
~I2C_PWR_EN: R5.1, U3.13 (PA3)

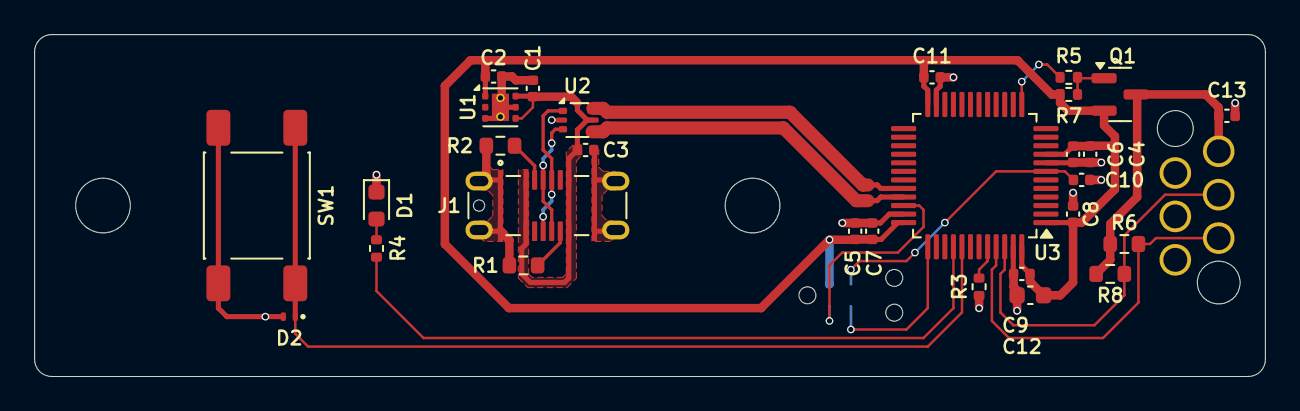
[picture p45: board Controller.kicad_pcb from above]

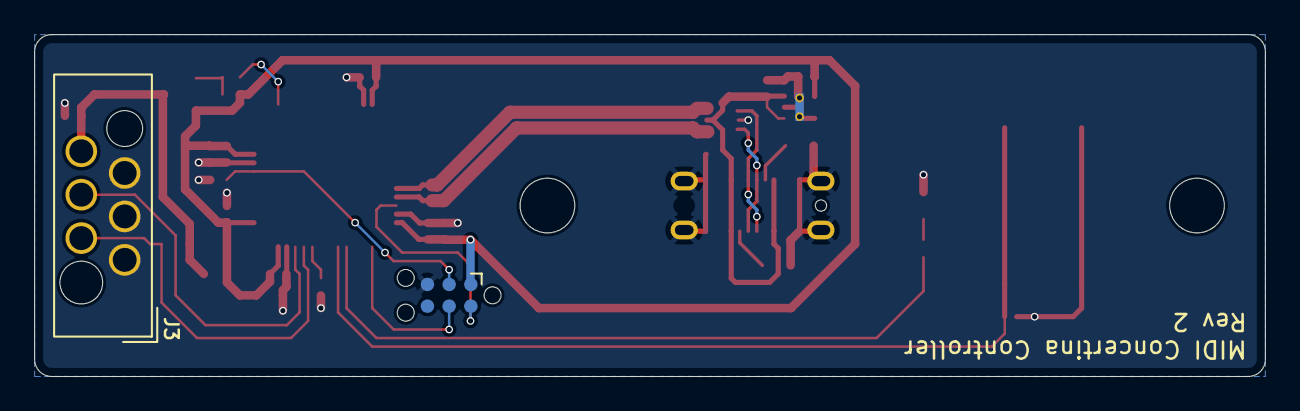
[picture p46: board Controller.kicad_pcb from below]

Board: 2 copper layers, 72.0 x 20.0 mm, 33 parts (2 on the bottom side), 21 nets.
