schult/midi_concertina/electrical/AngloRightKeyboard/AngloRightKeyboard.kicad_pcb

## KiCad design electrical/AngloRightKeyboard/AngloRightKeyboard.kicad_pcb (2026-01-20)

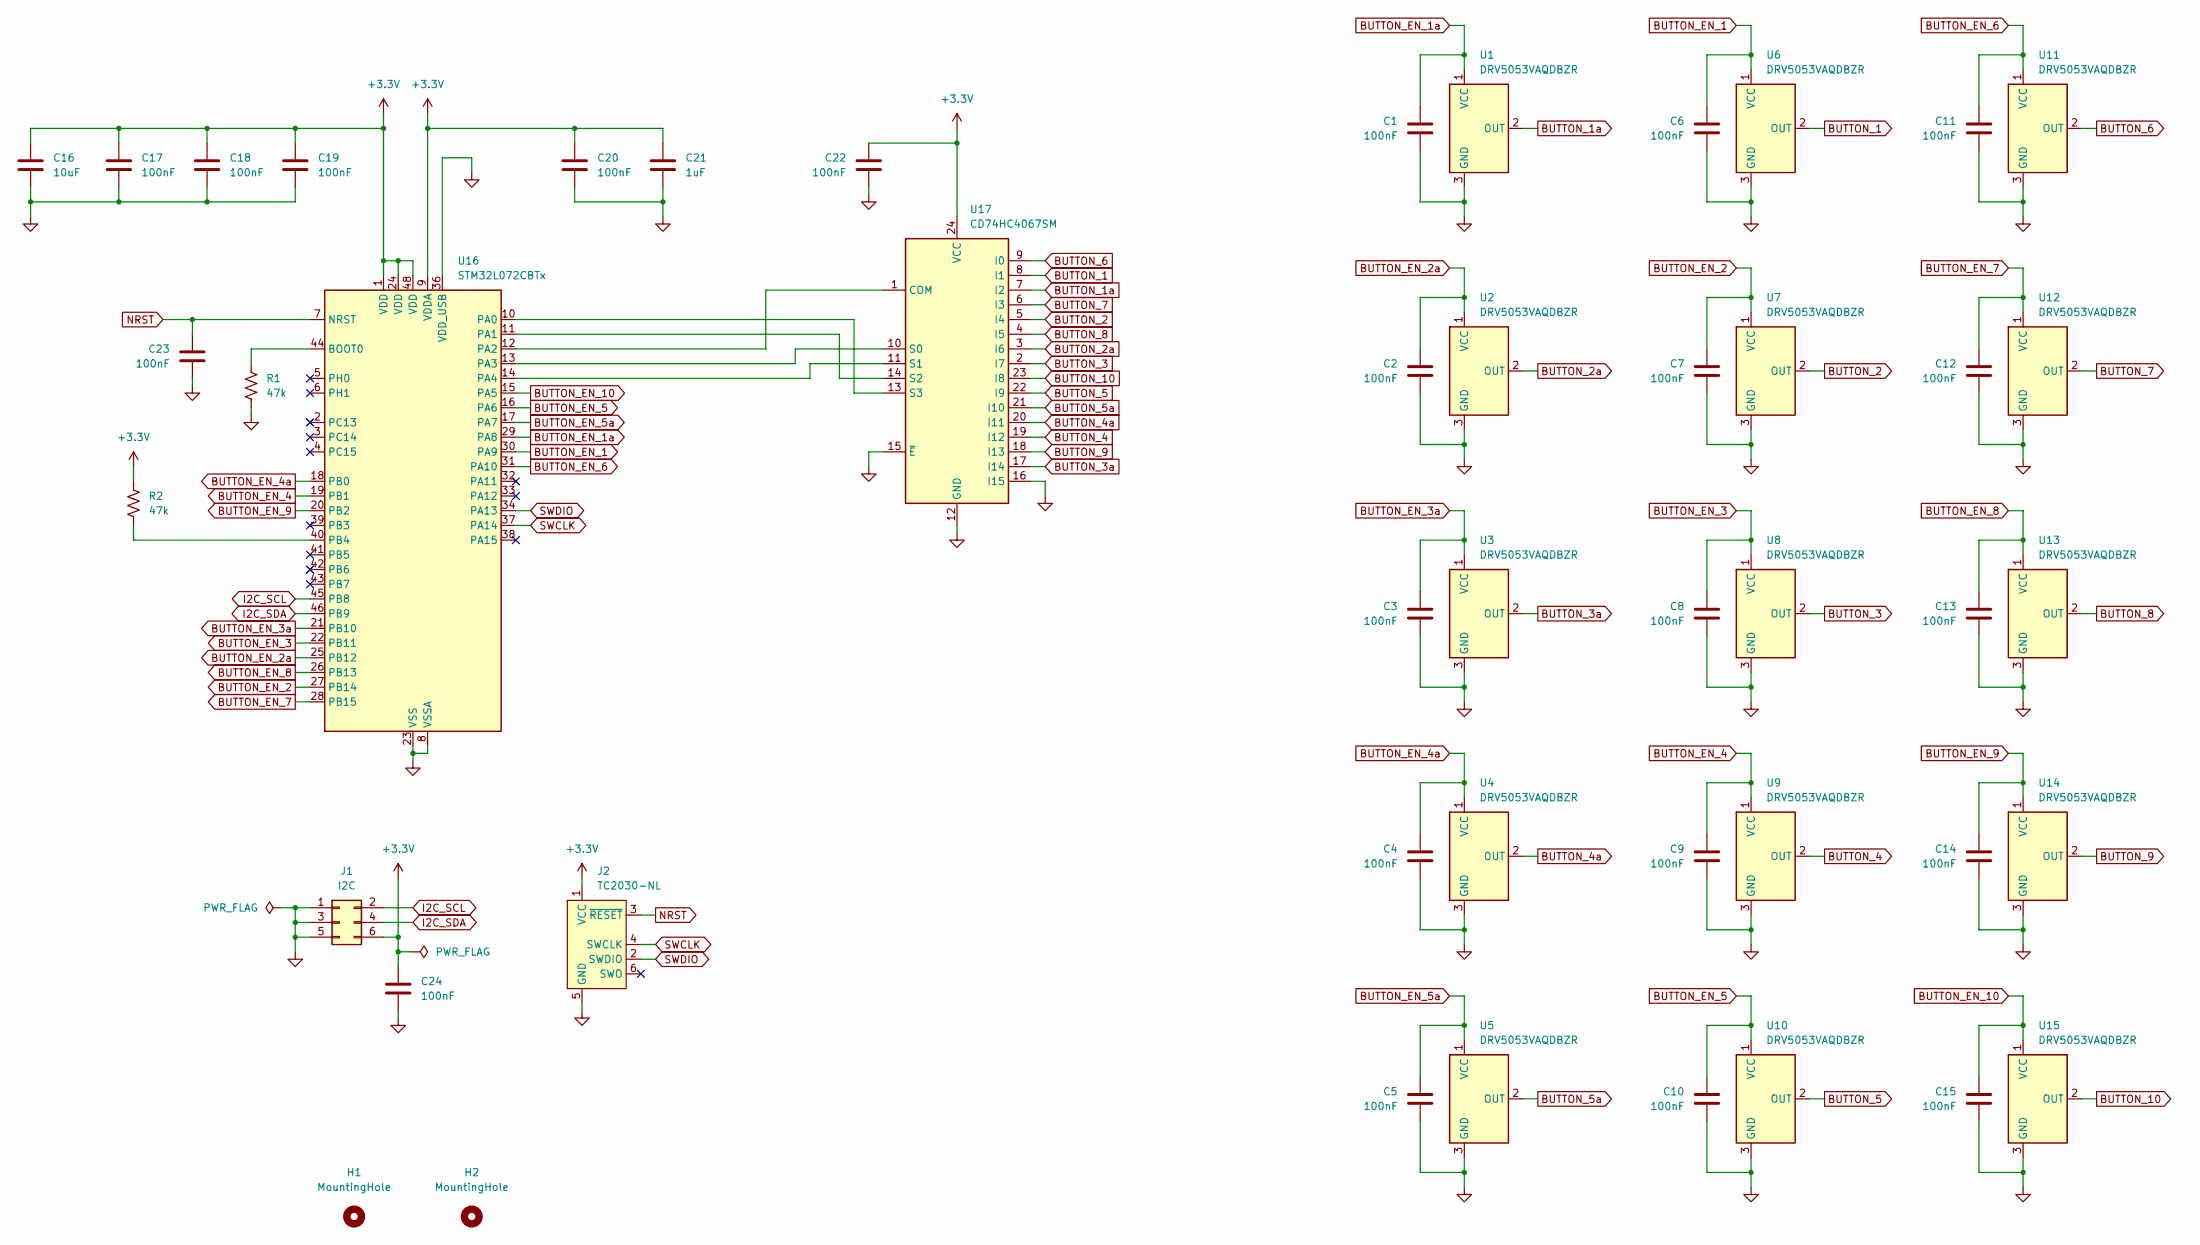
[picture p47: schematic AngloRightKeyboard.kicad_sch, MIDI Anglo Right Keyboard]

Parts:
C1, C2, C3, C4, C5, C6, C7, C8, C9, C10, C11, C12, C13, C14, C15, C17, C18, C19, C20, C22, C23, C24: 100nF; C_0402_1005Metric; Part Samsung CL05B104KO5NNNC; LCSC C1525
C16: 10uF; C_0603_1608Metric; Part Samsung CL10A106MA8NRNC; LCSC C96446
C21: 1uF; C_0402_1005Metric; Part Samsung CL05A105KA5NQNC; LCSC C52923
H1, H2: MountingHole; MountingHole_3.2mm_M3
J1: I2C; Wuerth_WR-WST_490107670612_2x03_P2.54mm_SKEDD
J2: TC2030-NL; Tag-Connect_TC2030-IDC-NL_2x03_P1.27mm_Vertical
R1, R2: 47k; R_0402_1005Metric; Part UNI-ROYAL 0402WGF4702TCE; LCSC C25792
U1, U2, U3, U4, U5, U6, U7, U8, U9, U10, U11, U12, U13, U14, U15: DRV5053VAQDBZR; SOT-23; Part TI DRV5053VAQDBZR; LCSC C962159
U16: STM32L072CBTx; LQFP-48_7x7mm_P0.5mm; Part STM32L072CBT6; LCSC C465977
U17: CD74HC4067SM; SSOP-24_5.3x8.2mm_P0.65mm; Part TI CD74HC4067SM96; LCSC C98457

Connections:
+3.3V: C16.1, C17.1, C18.1, C19.1, C20.1, C21.1, C22.1, C24.1, J1.6, J2.1 (VCC), R2.1, U16.1 (VDD), U16.9 (VDDA), U16.24 (VDD), U16.48 (VDD), U17.24 (VCC)
BUTTON_1: U6.2 (OUT), U17.8 (I1)
BUTTON_1a: U1.2 (OUT), U17.7 (I2)
BUTTON_2: U7.2 (OUT), U17.5 (I4)
BUTTON_2a: U2.2 (OUT), U17.3 (I6)
BUTTON_3: U8.2 (OUT), U17.2 (I7)
BUTTON_3a: U3.2 (OUT), U17.17 (I14)
BUTTON_4: U9.2 (OUT), U17.19 (I12)
BUTTON_4a: U4.2 (OUT), U17.20 (I11)
BUTTON_5: U10.2 (OUT), U17.22 (I9)
BUTTON_5a: U5.2 (OUT), U17.21 (I10)
BUTTON_6: U11.2 (OUT), U17.9 (I0)
BUTTON_7: U12.2 (OUT), U17.6 (I3)
BUTTON_8: U13.2 (OUT), U17.4 (I5)
BUTTON_9: U14.2 (OUT), U17.18 (I13)
BUTTON_10: U15.2 (OUT), U17.23 (I8)
BUTTON_EN_1: C6.1, U6.1 (VCC), U16.30 (PA9)
BUTTON_EN_1a: C1.1, U1.1 (VCC), U16.29 (PA8)
BUTTON_EN_2: C7.1, U7.1 (VCC), U16.27 (PB14)
BUTTON_EN_2a: C2.1, U2.1 (VCC), U16.25 (PB12)
BUTTON_EN_3: C8.1, U8.1 (VCC), U16.22 (PB11)
BUTTON_EN_3a: C3.1, U3.1 (VCC), U16.21 (PB10)
BUTTON_EN_4: C9.1, U9.1 (VCC), U16.19 (PB1)
BUTTON_EN_4a: C4.1, U4.1 (VCC), U16.18 (PB0)
BUTTON_EN_5: C10.1, U10.1 (VCC), U16.16 (PA6)
BUTTON_EN_5a: C5.1, U5.1 (VCC), U16.17 (PA7)
BUTTON_EN_6: C11.1, U11.1 (VCC), U16.31 (PA10)
BUTTON_EN_7: C12.1, U12.1 (VCC), U16.28 (PB15)
BUTTON_EN_8: C13.1, U13.1 (VCC), U16.26 (PB13)
BUTTON_EN_9: C14.1, U14.1 (VCC), U16.20 (PB2)
BUTTON_EN_10: C15.1, U15.1 (VCC), U16.15 (PA5)
GND: C1.2, C2.2, C3.2, C4.2, C5.2, C6.2, C7.2, C8.2, C9.2, C10.2, C11.2, C12.2, C13.2, C14.2, C15.2, C16.2, C17.2, C18.2, C19.2, C20.2, C21.2, C22.2, C23.2, C24.2, J1.1, J1.3, J1.5, J2.5 (GND), R1.2, U1.3 (GND), U2.3 (GND), U3.3 (GND), U4.3 (GND), U5.3 (GND), U6.3 (GND), U7.3 (GND), U8.3 (GND), U9.3 (GND), U10.3 (GND), U11.3 (GND), U12.3 (GND), U13.3 (GND), U14.3 (GND), U15.3 (GND), U16.8 (VSSA), U16.23 (VSS), U16.35 (VSS), U16.36 (VDD_USB), U16.47 (VSS), U17.12 (GND), U17.15 (~E), U17.16 (I15)
I2C_SCL: J1.2, U16.45 (PB8)
I2C_SDA: J1.4, U16.46 (PB9)
NRST: C23.1, J2.3 (~RESET), U16.7 (NRST)
unnamed: R1.1, U16.44 (BOOT0)
unnamed: U16.10 (PA0), U17.13 (S3)
unnamed: U16.11 (PA1), U17.14 (S2)
unnamed: U16.12 (PA2), U17.1 (COM)
unnamed: U16.13 (PA3), U17.10 (S0)
unnamed: U16.14 (PA4), U17.11 (S1)
unnamed: R2.2, U16.40 (PB4)
SWCLK: J2.4 (SWCLK), U16.37 (PA14)
SWDIO: J2.2 (SWDIO), U16.34 (PA13)

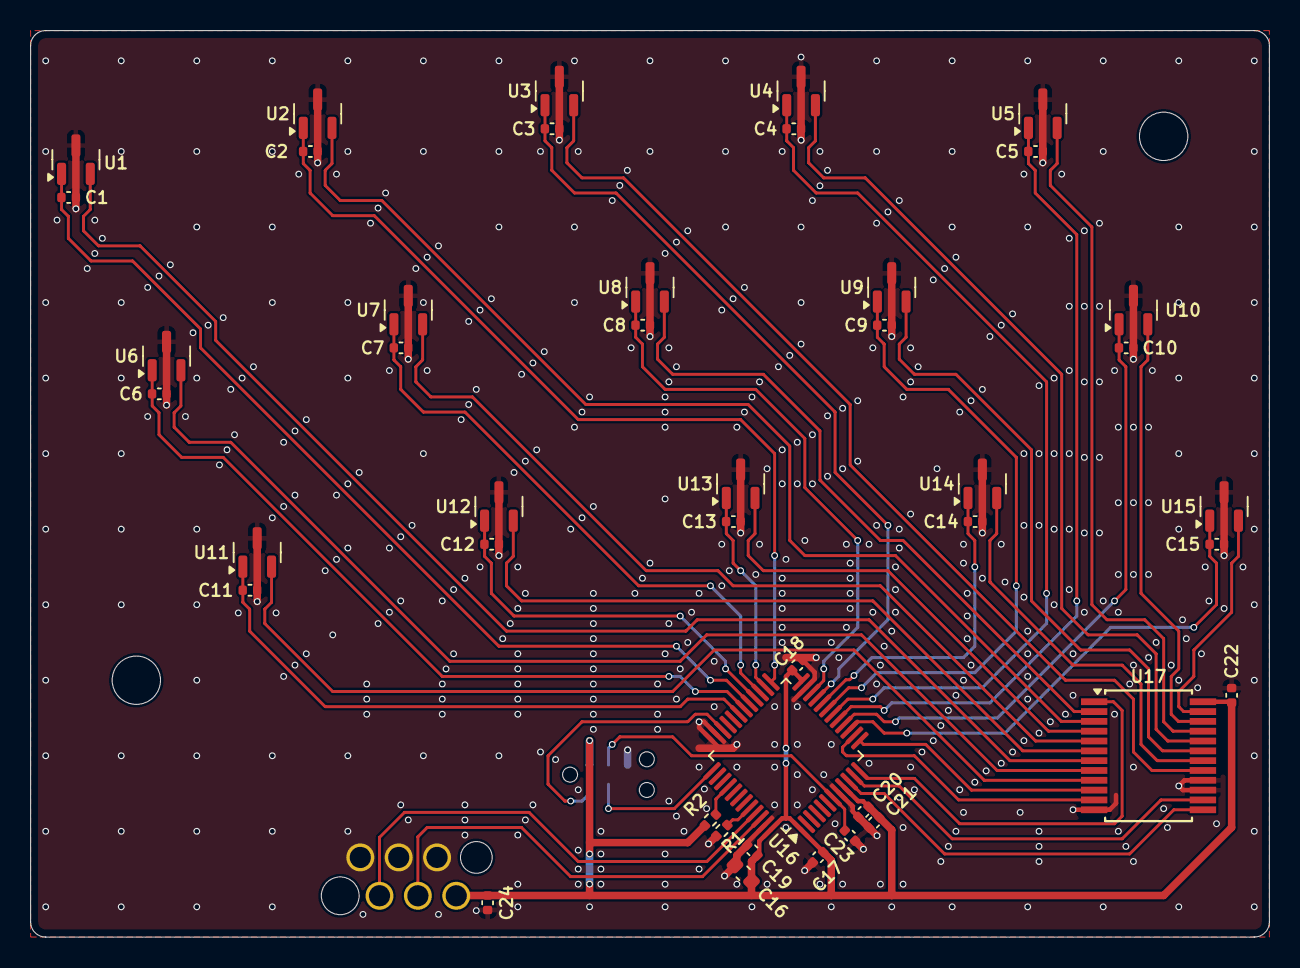
[picture p48: board AngloRightKeyboard.kicad_pcb from above]

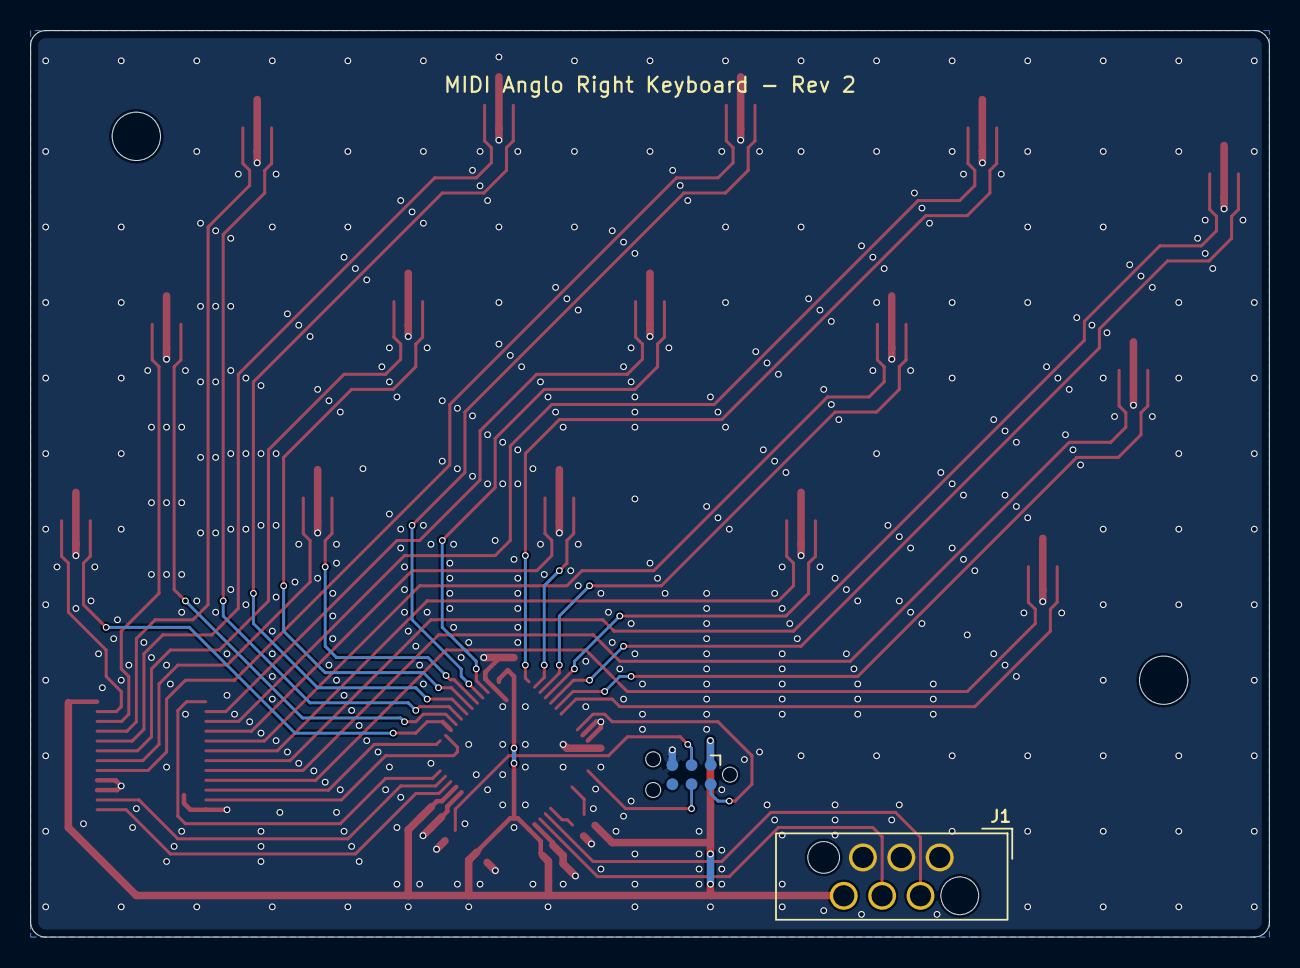
[picture p49: board AngloRightKeyboard.kicad_pcb from below]

Board: 2 copper layers, 82.0 x 60.0 mm, 47 parts (2 on the bottom side), 44 nets.
