schult/midi_concertina/electrical/control/control.kicad_pcb

## KiCad design electrical/control/control.kicad_pcb (2025-05-02)

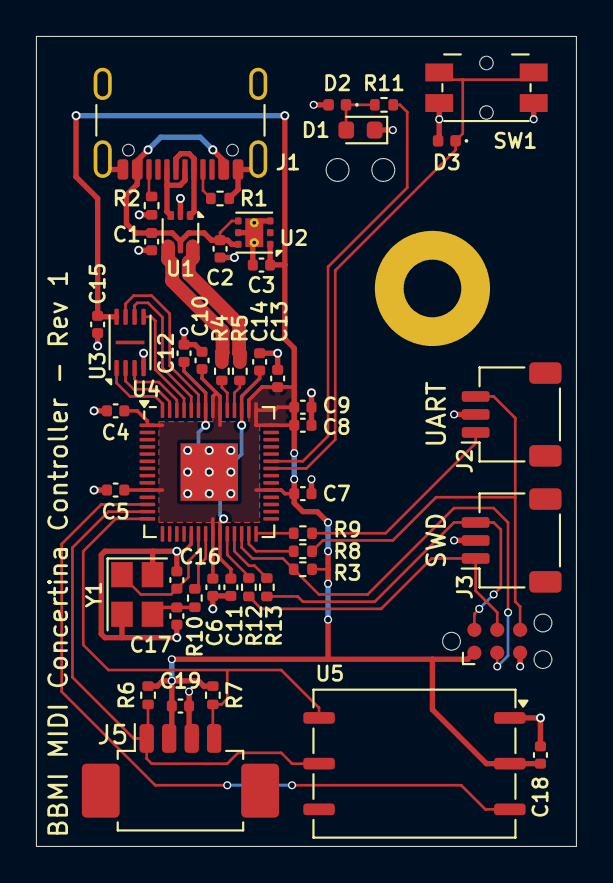
[picture p50: board control.kicad_pcb from above]

Board: 2 copper layers, 30.0 x 45.0 mm, 49 parts (0 on the bottom side), 36 nets.

Parts:
C1, C4, C5, C6, C7, C8, C9, C10, C11, C12, C15, C18, C19: 100n; C_0402_1005Metric
C2, C3, C13, C14: 1uF; C_0402_1005Metric
C16, C17: 15p; C_0402_1005Metric
D1: RED; LED_0603_1608Metric
D2, D3: ESD351; D_0402_1005Metric
H1: MountingHole; MountingHole_3.2mm_M3_Pad
H2: SLP-150-150-F; SLP3-150-150-F
J1: USB4105-GF-A; USB_C_Receptacle_GCT_USB4105-xx-A_16P_TopMnt_Horizontal
J2: UART; JST_SH_SM03B-SRSS-TB_1x03-1MP_P1.00mm_Horizontal
J3: SWD; JST_SH_SM03B-SRSS-TB_1x03-1MP_P1.00mm_Horizontal
J4: TC2030-NL; Tag-Connect_TC2030-IDC-NL_2x03_P1.27mm_Vertical
J5: I2C; Molex_PicoBlade_53261-0471_1x04-1MP_P1.25mm_Horizontal
R1, R2: 5k1; R_0402_1005Metric
R3, R10, R11: 1k; R_0402_1005Metric
R4, R5: 27R; R_0402_1005Metric
R6, R7: 2k2; R_0402_1005Metric
R8, R9, R12, R13: 100R; R_0402_1005Metric
SW1: SYS; Panasonic_EVQPUL_EVQPUC
U1: USBLC6-2P6; SOT-666
U2: LP5912-3.3DRV; WSON-6-1EP_2x2mm_P0.65mm_EP1x1.6mm_ThermalVias
U3: W25Q16JVUXIQ; Winbond_USON-8-1EP_3x2mm_P0.5mm_EP0.2x1.6mm
U4: RP2040; QFN-56-1EP_7x7mm_P0.4mm_EP3.2x3.2mm
U5: ABPMRRV060MG2A3; Honeywell_ABPMRRx
Y1: ABM8-272-T3; Crystal_SMD_3225-4Pin_3.2x2.5mm

Connections:
+1V1: C11.1, C12.1, C14.1, U4.23 (DVDD), U4.45 (VREG_VOUT), U4.50 (DVDD)
+3.3V: C3.1, C4.1, C5.1, C6.1, C7.1, C8.1, C9.1, C10.1, C13.1, C15.1, C18.1, C19.1, J4.1 (VCC), J5.2, R3.1, R6.1, R7.1, U2.1 (OUT), U3.8 (VCC), U4.1 (IOVDD), U4.10 (IOVDD), U4.22 (IOVDD), U4.33 (IOVDD), U4.42 (IOVDD), U4.43 (ADC_AVDD), U4.44 (VREG_IN), U4.48 (USB_VDD), U4.49 (IOVDD), U5.2 (VDD)
/QSPI_SCLK: U3.6 (CLK), U4.52 (QSPI_SCLK)
/QSPI_SD0: U3.5 (DI/IO_{0}), U4.53 (QSPI_SD0)
/QSPI_SD1: U3.2 (DO/IO_{1}), U4.55 (QSPI_SD1)
/QSPI_SD2: U3.3 (~WP/IO_{2}), U4.54 (QSPI_SD2)
/QSPI_SD3: U3.7 (~HOLD/~RESET/IO_{3}), U4.51 (QSPI_SD3)
/QSPI_SS: U3.1 (~CS), U4.56 (QSPI_SS)
GND: C1.2, C2.2, C3.2, C4.2, C5.2, C6.2, C7.2, C8.2, C9.2, C10.2, C11.2, C12.2, C13.2, C14.2, C15.2, C16.2, C17.2, C18.2, C19.2, D1.1 (K), D2.2 (A), D3.2 (A), H1.1, J1.A1 (GND), J1.A12 (GND), J1.B1 (GND), J1.B12 (GND), J1.S1 (SHIELD), J2.2, J3.2, J4.5 (GND), J5.3, R1.2, R2.2, SW1.2, U1.2 (GND), U2.3 (PG), U2.5 (GND), U2.7 (EP), U3.4 (GND), U4.19 (TESTEN), U4.57 (GND), U5.1 (GND), Y1.2, Y1.4
I2C_SCL: J5.4, R7.2, U4.14 (GPIO11), U5.6 (SCL)
I2C_SDA: J5.1, R6.2, U4.13 (GPIO10), U5.5 (SDA)
unnamed: C17.1, R10.1, Y1.3
unnamed: D1.2 (A), D2.1 (K), R11.2
unnamed: D3.1 (K), SW1.1, U4.36 (GPIO24)
unnamed: J1.A5 (CC1), R1.1
unnamed: J1.B5 (CC2), R2.1
unnamed: J1.A6 (D+), J1.B6 (D+), U1.3 (I/O2)
unnamed: J1.A7 (D-), J1.B7 (D-), U1.1 (I/O1)
unnamed: R8.1, U4.27 (GPIO16)
unnamed: R9.1, U4.28 (GPIO17)
unnamed: R11.1, U4.37 (GPIO25)
unnamed: R12.1, U4.24 (SWCLK)
unnamed: R13.1, U4.25 (SWD)
unnamed: R5.1, U4.46 (USB_DM)
unnamed: R4.1, U4.47 (USB_DP)
unnamed: C16.1, U4.20 (XIN), Y1.1
unnamed: R10.2, U4.21 (XOUT)
PRESSURE_INT: U4.12 (GPIO9), U5.3 (INT)
RUN: J4.3 (~RESET), R3.2, U4.26 (RUN)
SWCLK: J3.1, J4.4 (SWCLK), R12.2
SWDIO: J3.3, J4.2 (SWDIO), R13.2
UART_RX: J2.1, R9.2
UART_TX: J2.3, J4.6 (SWO), R8.2
USB_D+: R4.2, U1.4 (I/O2)
USB_D-: R5.2, U1.6 (I/O1)
VBUS: C1.1, C2.1, J1.A4 (VBUS), J1.A9 (VBUS), J1.B4 (VBUS), J1.B9 (VBUS), U1.5 (VBUS), U2.4 (EN), U2.6 (IN)
