schult/midi_concertina/(commit log)

2025-04-18 Create KiCad project for main control board
    [control.kicad_pcb, control.kicad_sch]
2025-04-18 Restore previous work on control board schematic
    [control.kicad_sch]
2025-04-18 ERC fix and minor cleanup
    [control.kicad_sch]
2025-04-18 Use standard symbols and footprints for connectors
    [control.kicad_sch]
2025-04-19 Clean up control board schematic
    [control.kicad_sch]
2025-04-19 Adjust LED and resistor selection
    [control.kicad_sch]
2025-04-20 Set JLC part numbers for various components
    [control.kicad_sch]
2025-04-20 Remove diode
    [control.kicad_sch]
2025-04-20 Reduce number of mounting holes
    [control.kicad_sch]
2025-04-20 Assign more part numbers and footprints
    [control.kicad_sch]
2025-04-20 Add power flags for VBUS and GND
    [control.kicad_sch]
2025-04-20 Add custom symbol library; change 1uF caps
    [control.kicad_sch]
2025-04-20 Reassign annotations
    [control.kicad_sch]
2025-05-02 Add footprint lib; various other changes
    [control.kicad_pcb, control.kicad_sch]
2025-05-02 USB PCB layout
    [control.kicad_pcb, control.kicad_sch]
2025-05-02 More PCB layout
    [control.kicad_pcb, control.kicad_sch]
2025-05-02 More PCB work
    [control.kicad_pcb, control.kicad_sch]
2025-05-02 All nets routed for control board
    [control.kicad_pcb, control.kicad_sch]
2025-05-02 Fix various DRC errors
    [control.kicad_pcb]
2025-05-02 Clean up silkscreen
    [control.kicad_pcb]
2025-05-02 Fix via sizes
    [control.kicad_pcb]
2025-05-02 PCB cleanup and DRC fixes
    [control.kicad_pcb]
2025-05-02 Adjust USB and power routing
    [control.kicad_pcb]
2025-05-02 More PCB tweaks
    [control.kicad_pcb]
2025-05-02 Position mechanical components
    [control.kicad_pcb, control.kicad_sch]
2025-05-02 Replace illuminated button with separate components
    [control.kicad_pcb, control.kicad_sch]
2025-05-02 Label debug connectors
    [control.kicad_pcb]
2025-05-02 Update parts for controller board
    [control.kicad_pcb, control.kicad_sch]
2025-05-02 Replace I2C connector
    [control.kicad_pcb, control.kicad_sch]
2025-05-02 Update courtyards for custom footprints
    [control.kicad_pcb]
2025-05-02 Restore default 3d model paths
    [control.kicad_pcb]
2025-05-02 Rename control board project
    [Controller.kicad_pcb, Controller.kicad_sch]
2025-05-02 Rename symbol library
    [Controller.kicad_pcb, Controller.kicad_sch]
2025-05-02 Rename footprint library
    [Controller.kicad_pcb, Controller.kicad_sch]
2025-05-02 Remove reference to missing 3d model
    [Controller.kicad_pcb]
2025-05-06 Replace pressure sensor with correct part and fatten power traces
    [Controller.kicad_pcb, Controller.kicad_sch]
2025-05-06 Expand pressure sensor courtyard
    [Controller.kicad_pcb]
2025-05-08 Use 5-pin connector for I2C
    [Controller.kicad_pcb, Controller.kicad_sch]
2025-05-11 More work on controller design
    [Controller.kicad_pcb, Controller.kicad_sch]
2025-05-12 Adjust I2C layout
    [Controller.kicad_pcb, Controller.kicad_sch]
2025-05-21 Add Kicad project for right-hand electronics
    [AngloRightHand.kicad_pcb, AngloRightHand.kicad_sch, Controller.kicad_pcb]
2025-05-22 All nets routed for right hand board
    [AngloRightHand.kicad_pcb, AngloRightHand.kicad_sch]
2025-05-23 Reduce size of right hand board
    [AngloRightHand.kicad_pcb, AngloRightHand.kicad_sch]
2025-05-23 Clean up right hand schematic
    [AngloRightHand.kicad_pcb, AngloRightHand.kicad_sch]
2025-05-23 Renumber parts on right hand board
    [AngloRightHand.kicad_pcb, AngloRightHand.kicad_sch]
2025-05-23 Change board label silkscreen
    [AngloRightHand.kicad_pcb, Controller.kicad_pcb]
2025-05-24 Add board for left hand
    [AngloLeftHand.kicad_pcb, AngloLeftHand.kicad_sch]
2025-05-25 Add stitching vias
    [AngloLeftHand.kicad_pcb, AngloRightHand.kicad_pcb]
2025-06-01 Redesign controller schematic with STM32
    [Controller.kicad_pcb, Controller.kicad_sch]
2025-06-09 Swap SDA and SCL on button board connectors
    [AngloLeftHand.kicad_pcb, AngloLeftHand.kicad_sch, AngloRightHand.kicad_pcb, AngloRightHand.kicad_sch]
2025-06-09 Layout controller PCB with STM32 and updated connector pinout
    [Controller.kicad_pcb, Controller.kicad_sch]
2025-06-17 PCB adjustments
    [AngloLeftHand.kicad_pcb, AngloLeftHand.kicad_sch, AngloRightHand.kicad_pcb, AngloRightHand.kicad_sch, Controller.kicad_pcb, Controller.kicad_sch]
2025-06-21 Add mechanical design for right-hand faceplate
    [Parameters.FCStd, RightFaceplate.FCStd]
2025-06-21 Add licenses
    [AngloLeftHand.kicad_pcb, AngloLeftHand.kicad_sch, AngloRightHand.kicad_pcb, AngloRightHand.kicad_sch, Controller.kicad_pcb, Controller.kicad_sch, Parameters.FCStd, RightFaceplate.FCStd]
2025-06-21 Add mechanical design for left faceplate
    [LeftFaceplate.FCStd]
2025-06-21 Change naming convention for mechanical parts
    [Faceplate_Left.FCStd, Faceplate_Right.FCStd]
2025-06-21 Use generic body names in FreeCAD files
    [Faceplate_Left.FCStd, Faceplate_Right.FCStd]
2025-06-21 Add mechanical design for trim
    [Faceplate_Right.FCStd, Parameters.FCStd, Trim.FCStd]
2025-06-22 Add mechanical design for handrests
    [Handrest.FCStd, Parameters.FCStd]
2025-06-22 Remove counterdrill from handrest holes in faceplates
    [Faceplate_Left.FCStd, Faceplate_Right.FCStd, Trim.FCStd]
2025-06-25 Use wide layout for controller PCB
    [Controller.kicad_pcb, Controller.kicad_sch]
2025-06-25 Use 0402 resistors for i2c pull-ups
    [Controller.kicad_pcb, Controller.kicad_sch]
2025-06-27 Move debug header within controller bounding rect
    [Controller.kicad_pcb]
2025-06-27 Round PCB corners
    [AngloLeftHand.kicad_pcb, AngloRightHand.kicad_pcb]
2025-08-12 Incomplete first pass at right valve block
    [Parameters.FCStd, ValveBlock_Right.FCStd]
2025-08-12 Create standalone bellows sensor board
    [BellowsSensor.kicad_pcb, BellowsSensor.kicad_sch]
2025-08-13 Change controller board form factor
    [Controller.kicad_pcb, Controller.kicad_sch]
2025-09-20 Controller board mounting
    [ControllerPanel.FCStd, ControllerPanelRetainer.FCStd, Faceplate_Right.FCStd, Parameters.FCStd, ValveBlock_Right.FCStd]
2025-10-02 Rework mechanical mount for controller board
    [ControllerPanel.FCStd, ControllerPanelRetainer.FCStd, Parameters.FCStd, ValveBlock_Right.FCStd]
2025-10-02 Replace pressure sensor part
    [BellowsSensor.kicad_pcb, BellowsSensor.kicad_sch]
2025-10-02 Minor corrections to controller design
    [Controller.kicad_pcb, Controller.kicad_sch]
2025-10-02 Minor corrections to bellows sensor design
    [BellowsSensor.kicad_pcb, BellowsSensor.kicad_sch]
2025-10-02 Minor corrections to right hand board
    [AngloRightHand.kicad_pcb, AngloRightHand.kicad_sch]
2025-10-02 Minor corrections to left hand board
    [AngloLeftHand.kicad_pcb, AngloLeftHand.kicad_sch]
2025-10-03 Switch pressure sensors again
    [BellowsSensor.kicad_pcb, BellowsSensor.kicad_sch]
2025-10-03 Set board dates and revisions following first purchase
    [AngloLeftHand.kicad_pcb, AngloLeftHand.kicad_sch, AngloRightHand.kicad_pcb, AngloRightHand.kicad_sch, Controller.kicad_pcb, Controller.kicad_sch]
2025-10-16 Create rust project for controller board firmware
2025-10-16 Perform LED blink test in controller firmware
2025-10-16 Connect LED to switch state
2025-10-20 Make controller firmware act as a MIDI device
2025-10-20 Sync controller led to note on/off
2025-11-08 Use correct page size in bootloader
    [main.rs]
2025-11-23 Implement basic i2c communication
2025-11-23 Fix part selection for i2c pull-ups
    [Controller.kicad_pcb, Controller.kicad_sch]
2025-11-23 Remove UART from debug connector
    [AngloLeftHand.kicad_pcb, AngloLeftHand.kicad_sch, AngloRightHand.kicad_pcb, AngloRightHand.kicad_sch, Controller.kicad_pcb, Controller.kicad_sch]
2025-11-23 Use REVISION var to fill silkscreen
    [AngloLeftHand.kicad_pcb, AngloRightHand.kicad_pcb, BellowsSensor.kicad_pcb, Controller.kicad_pcb]
2025-11-23 Replace PicoBlade connectors with SKEDD
    [AngloLeftHand.kicad_pcb, AngloLeftHand.kicad_sch, AngloRightHand.kicad_pcb, AngloRightHand.kicad_sch, BellowsSensor.kicad_pcb, BellowsSensor.kicad_sch, Controller.kicad_pcb, Controller.kicad_sch]
2025-11-24 Relabel components
    [AngloLeftHand.kicad_pcb, AngloLeftHand.kicad_sch, AngloRightHand.kicad_pcb, AngloRightHand.kicad_sch, BellowsSensor.kicad_pcb, BellowsSensor.kicad_sch, Controller.kicad_pcb, Controller.kicad_sch]
2025-11-28 Set grid/drill origins and missing title
    [AngloLeftHand.kicad_pcb, AngloRightHand.kicad_pcb, BellowsSensor.kicad_pcb, Controller.kicad_pcb]
2025-11-28 Use TITLE variable in silkscreen
    [AngloLeftHand.kicad_pcb, AngloRightHand.kicad_pcb, BellowsSensor.kicad_pcb, Controller.kicad_pcb]
2025-11-28 Rename kicad projects for keyboards
    [AngloLeftKeyboard.kicad_pcb, AngloLeftKeyboard.kicad_sch, AngloRightKeyboard.kicad_pcb, AngloRightKeyboard.kicad_sch]
2025-11-28 Update titles in kicad files
    [AngloLeftKeyboard.kicad_pcb, AngloLeftKeyboard.kicad_sch, AngloRightKeyboard.kicad_pcb, AngloRightKeyboard.kicad_sch, BellowsSensor.kicad_sch]
2025-11-30 Play notes based on reported button states
2025-11-30 Enable extra i2c pullups
2025-11-30 Read pressure sensor for bellows
2025-12-04 Add gpio-controlled switch for i2c bus power
    [Controller.kicad_pcb, Controller.kicad_sch]
2025-12-09 Prevent optimization of unused variable
    [main.rs]
2025-12-10 Change i2c cable pinout to keep signals between grounds
    [AngloLeftKeyboard.kicad_pcb, AngloLeftKeyboard.kicad_sch, AngloRightKeyboard.kicad_pcb, AngloRightKeyboard.kicad_sch, BellowsSensor.kicad_pcb, BellowsSensor.kicad_sch, Controller.kicad_pcb, Controller.kicad_sch]
2025-12-28 Add clearance cutout to controller panel
    [ControllerPanel.FCStd]
2026-01-02 Add lib for i2c protocol
2026-01-17 Move cutout to correct side
    [ControllerPanel.FCStd]
2026-01-17 Extract button scanning task to new module
2026-01-18 Use i2c-proto to respond to button reads
2026-01-19 Add skeleton for handling i2c protocol in anglo-keyboard
2026-01-19 Switch to MCU part with more flash for controller board
    [Controller.kicad_pcb, Controller.kicad_sch]
2026-01-19 Move mode ownership to main/i2c task
2026-01-20 Update board revisions and dates
    [AngloLeftKeyboard.kicad_pcb, AngloLeftKeyboard.kicad_sch, AngloRightKeyboard.kicad_pcb, AngloRightKeyboard.kicad_sch, BellowsSensor.kicad_pcb, BellowsSensor.kicad_sch, Controller.kicad_pcb, Controller.kicad_sch]
2026-01-20 Exclude I2C connectors from BOM
    [AngloLeftKeyboard.kicad_pcb, AngloLeftKeyboard.kicad_sch, AngloRightKeyboard.kicad_pcb, AngloRightKeyboard.kicad_sch, BellowsSensor.kicad_pcb, BellowsSensor.kicad_sch, Controller.kicad_pcb, Controller.kicad_sch]
2026-01-25 Add hysteresis to button inputs
2026-01-25 Update i2c code after hardware fix
    [main.rs]
2026-01-25 Add support for pressure sensor to i2c-proto Controller
2026-01-25 Use i2c-proto for communication in anglo-controller
2026-01-25 Use PWM to control LED brightness
2026-01-25 Move bellows ratio calculation into i2c-proto
2026-02-02 Transfer firmware from controller to keyboards (broken).
    [main.rs]
2026-02-18 Reduce i2c message size
2026-02-18 Improve i2c device error reporting
2026-02-18 Update anglo-keyboard i2c config
2026-02-18 Use LED to indicate firmware update status
2026-02-18 Make main/i2c task yield
2026-02-22 Update embassy to fix i2c comms
    [buttons.rs, main.rs]
2026-03-01 Apply fretwork patterns to faceplates
    [Faceplate_Left.FCStd, Faceplate_Right.FCStd, Parameters.FCStd, Trim.FCStd]
2026-03-04 Use reference sketches for keyboard layouts
    [Faceplate_Left.FCStd, Faceplate_Right.FCStd, Parameters.FCStd, ValveBlock_Right.FCStd]
2026-03-05 Add MagnetPost design
    [Faceplate_Left.FCStd, Faceplate_Right.FCStd, MagnetPost.FCStd, Parameters.FCStd, ValveBlock_Right.FCStd]
2026-03-06 Add keyboard standoffs to right valve block
    [Parameters.FCStd, ValveBlock_Right.FCStd]
2026-03-07 Add action board design
    [ActionBoard_Right.FCStd, Parameters.FCStd, ValveBlock_Right.FCStd]
2026-03-07 Clean up aliases in mechanical designs
    [ActionBoard_Right.FCStd, ControllerPanel.FCStd, ControllerPanelRetainer.FCStd, Faceplate_Left.FCStd, Faceplate_Right.FCStd, Handrest.FCStd, MagnetPost.FCStd, Parameters.FCStd]
2026-03-07 Reduce trim profile radius
    [Trim.FCStd]
2026-03-07 Rename model sketches/operations
    [ControllerPanelRetainer.FCStd]
2026-03-08 Assorted mechanical work
    [ActionBoard_Right.FCStd, ButtonCap.FCStd, ButtonFlange_Air.FCStd, ButtonFlange_Note.FCStd, ControllerPanel.FCStd, ControllerPanelRetainer.FCStd, Parameters.FCStd, Trim.FCStd]
2026-03-09 Add left hand valve block and action board
    [ActionBoard_Left.FCStd, ActionBoard_Right.FCStd, ButtonCap.FCStd, ButtonFlange_Air.FCStd, ButtonFlange_Note.FCStd, ControllerPanel.FCStd, ControllerPanelRetainer.FCStd, Parameters.FCStd]
2026-03-10 Add hand strap template
    [Straps.dxf]
2026-03-10 Left valve block changes
    [ValveBlock_Left.FCStd]
2026-03-11 Adjust countersink parameters
    [ControllerPanelRetainer.FCStd, Faceplate_Left.FCStd, Faceplate_Right.FCStd, Parameters.FCStd]
2026-03-11 Add bellows frame design
    [BellowsFrame.FCStd]
2026-03-11 Update valve blocks to match other components
    [ControllerPanelRetainer.FCStd, ValveBlock_Left.FCStd, ValveBlock_Right.FCStd]
2026-03-11 Recompute trim
    [Trim.FCStd]
2026-03-11 Restore screw head clearance (and hole positions)
    [ActionBoard_Left.FCStd, ActionBoard_Right.FCStd, BellowsFrame.FCStd, ButtonCap.FCStd, ButtonFlange_Air.FCStd, ButtonFlange_Note.FCStd, ControllerPanel.FCStd, ControllerPanelRetainer.FCStd]
2026-03-12 Add support rib to bellows frame
    [BellowsFrame.FCStd]
2026-03-12 Adjust strap design
    [Straps.dxf]
2026-03-14 Adjust handrest and countersink
    [ControllerPanelRetainer.FCStd, Faceplate_Left.FCStd, Faceplate_Right.FCStd, Handrest.FCStd, Parameters.FCStd]
2026-03-15 Add some print settings to mechanical readme
2026-03-16 More print settings
2026-03-28 Adjust valve block thickness
    [Parameters.FCStd, ValveBlock_Left.FCStd, ValveBlock_Right.FCStd]
2026-03-28 Adjust action board standoff position
    [ActionBoard_Right.FCStd, Parameters.FCStd, ValveBlock_Right.FCStd]
2026-03-28 Add design for bellows cards
    [BellowsCards.dxf]
2026-03-28 Update to FreeCAD 1.1
    [ActionBoard_Left.FCStd, ActionBoard_Right.FCStd, BellowsFrame.FCStd, ButtonCap.FCStd, ButtonFlange_Air.FCStd, ButtonFlange_Note.FCStd, ControllerPanel.FCStd, ControllerPanelRetainer.FCStd]
2026-03-28 Update button cap for thicker valve wall
    [ButtonCap.FCStd]
2026-03-28 Include clearance in handrest prong hole diameter
    [Handrest.FCStd]
2026-03-28 Simplify sketch constraints
    [ControllerPanelRetainer.FCStd, ValveBlock_Right.FCStd]
2026-03-28 Reduce tight clearance for better results with PETG
    [ActionBoard_Left.FCStd, ActionBoard_Right.FCStd, BellowsFrame.FCStd, ButtonCap.FCStd, ButtonFlange_Air.FCStd, ButtonFlange_Note.FCStd, ControllerPanel.FCStd, ControllerPanelRetainer.FCStd]
2026-03-28 Update links in FreeCAD files
    [ActionBoard_Left.FCStd, ActionBoard_Right.FCStd, BellowsFrame.FCStd, ButtonCap.FCStd, ButtonFlange_Air.FCStd, ButtonFlange_Note.FCStd, ControllerPanel.FCStd, ControllerPanelRetainer.FCStd]
2026-03-29 Copy BellowsSensor Kicad project
    [BellowsSensorA.kicad_pcb, BellowsSensorA.kicad_sch]
2026-03-29 Switch pressure sensor for BellowsSensorA
    [BellowsSensorA.kicad_pcb, BellowsSensorA.kicad_sch]
2026-03-29 Copy BellowsSensorA Kicad project
    [BellowsSensorB.kicad_pcb, BellowsSensorB.kicad_sch]
2026-03-29 Switch pressure sensor for BellowsSensorB
    [BellowsSensorB.kicad_pcb, BellowsSensorB.kicad_sch]
2026-03-29 Update bellows sensor labels
    [BellowsSensorA.kicad_pcb, BellowsSensorA.kicad_sch, BellowsSensorB.kicad_pcb, BellowsSensorB.kicad_sch]
2026-03-29 Adjust silkscreen
    [BellowsSensorA.kicad_pcb]
2026-03-29 Update dates for bellows sensor designs
    [BellowsSensorA.kicad_pcb, BellowsSensorA.kicad_sch, BellowsSensorB.kicad_pcb, BellowsSensorB.kicad_sch]
2026-03-29 Add solder bridges to BellowsSensorB
    [BellowsSensorB.kicad_pcb, BellowsSensorB.kicad_sch]
2026-03-30 Remove countersink from ControllerPanelRetainer
    [ControllerPanelRetainer.FCStd]
2026-04-01 Remove chamfer from bottom of MagnetPost
    [MagnetPost.FCStd]
2026-04-01 Redesign button flanges
    [ButtonFlange_Air.FCStd, ButtonFlange_Note.FCStd]
2026-04-01 Replace alias reference in ButtonCap
    [ButtonCap.FCStd]
2026-04-01 Switch to custom button bushing to reduce clatter
    [ActionBoard_Left.FCStd, ActionBoard_Right.FCStd, BellowsFrame.FCStd, ButtonBushing.FCStd, ButtonCap.FCStd, ButtonFlange_Air.FCStd, ButtonFlange_Note.FCStd, ControllerPanel.FCStd]
2026-04-01 Improve custom button bushing
    [ButtonBushing.FCStd]
2026-04-03 Add tool for measuring/installing button wires
    [ButtonCap.FCStd, ButtonWireJig.FCStd, MagnetPost.FCStd, Parameters.FCStd]
2026-04-05 Adjust button wire fit
    [ActionBoard_Left.FCStd, ActionBoard_Right.FCStd, BellowsFrame.FCStd, ButtonBushing.FCStd, ButtonCap.FCStd, ButtonFlange_Air.FCStd, ButtonFlange_Note.FCStd, ButtonWireJig.FCStd]
2026-04-09 Add PCB standoffs
    [PcbStandoff1_Left.FCStd, PcbStandoff1_Right.FCStd, PcbStandoff2.FCStd]
2026-04-10 Add laser cut pattern to bellows card dxf
    [BellowsCards.dxf]
2026-04-10 Switch column order
2026-04-10 Add instructions for buckle construction
2026-04-10 BOM corrections
2026-04-11 Adjust button wire jig
    [ButtonWireJig.FCStd]
2026-04-11 Add ControllerPanelButton design
    [ControllerPanelButton.FCStd]
2026-04-11 Add bellows marking template to BellowsCards.dxf
    [BellowsCards.dxf]
2026-04-18 Increase left action board size to suppport PCB standoff
    [ActionBoard_Left.FCStd]
2026-04-18 Reduce valve hole size
    [ValveBlock_Left.FCStd, ValveBlock_Right.FCStd]
2026-04-18 Add print settings note in readme
2026-04-18 Add initial version of bellows string jig
    [BellowsStringJig.FCStd]
2026-04-22 Add cable guide
    [CableGuide.FCStd]
2026-04-22 Adjust size of valve holes
    [ValveBlock_Left.FCStd, ValveBlock_Right.FCStd]
2026-06-06 Wrap i2c master in mutex
2026-06-06 Add bellows gasket design
    [BellowsGasket.FCStd]
2026-06-06 Create task for reading new pressure sensor
2026-06-07 Fix pressure sensor code and apply basic volume adjustment
    [bellows.rs, main.rs]
2026-06-08 Translate bellows transfer function from previous prototype
2026-06-09 Replace bellows state signal with a watcher
    [bellows.rs, main.rs]
2026-06-10 Move i2c setup to its own module
2026-06-12 Track controller mode
2026-06-13 Create separate task to handle button
2026-06-13 Adjust LED animation
2026-06-13 Make LED react to button being held
2026-06-14 Adjust LED timing
2026-06-15 Update gitignore for kicad
2026-06-15 Blink LED in bootloader
2026-06-15 Switch to blocking i2c in mutex
2026-06-17 Reduce i2c timeout and add retries instead
2026-06-18 Yield before i2c retry
2026-06-18 Change approach to bellows i2c retries
2026-06-19 Move keyboard init/upgrade into i2c module
2026-07-04 Add anchor point for cable guide
    [CableGuide.FCStd, Parameters.FCStd, PcbStandoff2.FCStd]
2026-07-04 Remove bellows string jig
    [BellowsStringJig.FCStd]
2026-07-11 Move i2c power handling
2026-07-11 Switch back to async i2c
2026-07-13 Rework keyboard update in anglo-controller
    [i2c.rs, keyboard.rs, main.rs]
2026-09-07 Add commented code for alternative pressure sensor
2026-09-19 Add features for selecting bellows sensor
2026-09-19 Adjust button trigger range
2026-09-19 Fix offset for bellows sensor b
    [bellows.rs]
2026-09-19 Remove bellows sensor b
    [BellowsSensorB.kicad_pcb, BellowsSensorB.kicad_sch]
2026-09-19 Fix mismatched i2c speeds
    [i2c.rs]
2026-09-20 Increase i2c speed
2026-09-22 Remove previous bellows sensor project
    [BellowsSensor.kicad_pcb, BellowsSensor.kicad_sch]
2026-10-06 Set USB VID and PID
2026-11-07 Show install locations for heat-set inserts
2026-11-08 Add missing handrest heat-set inserts in build instructions
2026-11-09 Add photos for handrest buckle
2026-11-11 Add photos of faceplate assemblies
2026-11-12 Add photos of button assembly
