schult/midi_concertina/(notices)

Notices in the files:
electrical/Controller/Controller.kicad_sch:
Licensed under CERN-OHL-S v2 or any later version
Copyright 2025 Steven Schulteis
